TakuroFukamizu/cores3-ilda/firmware/README.md

# CoreS3ファームウェア

今後の実装先です。まだソースコードはありません。Arduino／ESP-IDF／PlatformIO等の採用は未決定です。

GPIO割当、DAC設定、起動時レーザーOFFの要件は [ハードウェアREADME](../hardware/rev-a/README.md) を参照してください。生成物とローカル設定はGitに含めません。
