TakuroFukamizu/cores3-ilda/releases/rev-a/2026-10-02/README.md

# Rev.A 初回設計スナップショット

2026-10-02に作成した設計に対する製造データ・プレビュー・検査記録です。2026-10-06にモノレポへ移管しました。実基板による検証完了を意味しません。

- `manufacturing/`：Gerber、PTH/NPTHドリル、ジョブ情報、ドリル図
- `verification/`：ERC、DRC、理想DC解析の記録
- `schematic_svg/`：回路図全ページ
- `assembly-top.svg`、`board-top.svg`、`board-top.png`：配置／基板プレビュー

編集用設計は `hardware/rev-a/kicad/`、部品表は `hardware/rev-a/` にあります。変更後の成果物でこの初回記録を上書きせず、新しい日付のフォルダへ保存してください。製造時は該当する設計コミットも固定してください。
