TakuroFukamizu/cores3-ilda/docs/README.md

# 共通ドキュメント

ハードウェアとソフトウェアをまたぐ通信仕様、校正方法、実機評価記録、設計判断をここで管理します。

Rev.Aの現行仕様は [hardware/rev-a/README.md](../hardware/rev-a/README.md)、初回の電気ルール検査結果は [releases/rev-a/2026-10-02/verification](../releases/rev-a/2026-10-02/verification) を参照してください。
