TakuroFukamizu/cores3-ilda/software/README.md

# PC側ソフトウェア

評価・データ変換・制御用のツールやアプリを今後配置します。現時点では未実装です。
