TakuroFukamizu/cores3-ilda/releases/rev-a/2026-10-02/board-top.png

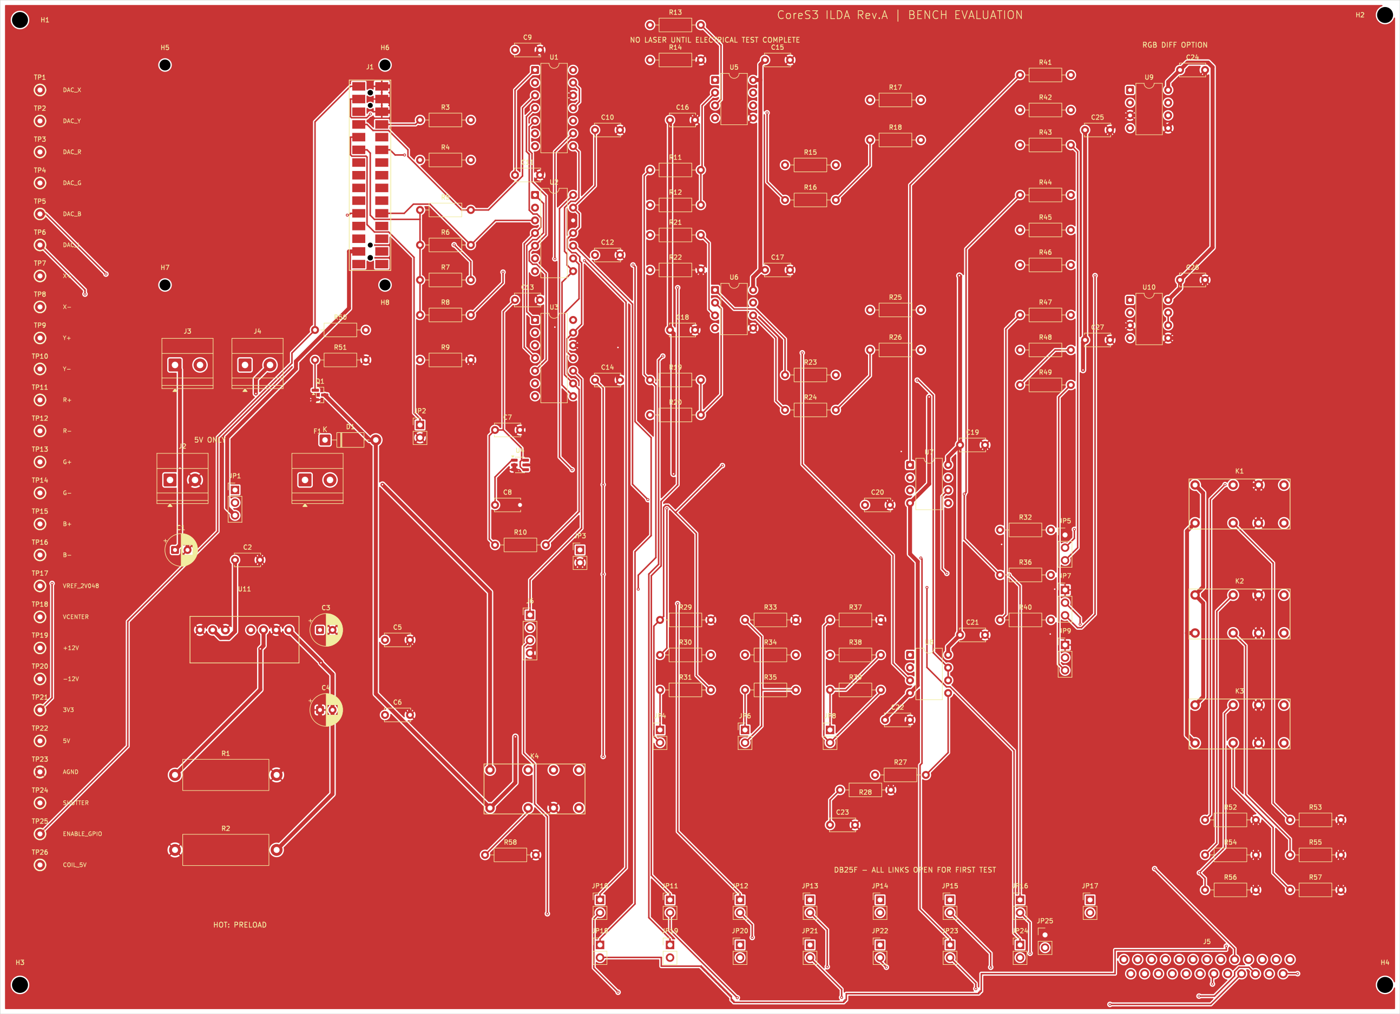
releases/rev-a/2026-10-02/board-top.png
