TakuroFukamizu/cores3-ilda/releases/rev-a/2026-10-02/verification/nominal_dc.csv

DAC_code | RGB_mode | Vcenter_V | Xplus_internal_V | Xminus_internal_V | XY_diff_V | RGBplus_internal_V | RGBminus_internal_V | RGB_diff_V
0 | SE | 1.024 | -4.8128 | 4.8128 | -9.6256 | 0.0 | 0 | 0.0
2048 | SE | 1.024 | 3.352467243869647e-16 | -3.3524672438696463e-16 | 6.704934487739293e-16 | 2.478080000000001 | 0 | 2.478080000000001
4095 | SE | 1.0240000000000002 | 4.810449999999999 | -4.810449999999999 | 9.620899999999997 | 4.954950000000002 | 0 | 4.954950000000002
0 | DIFF | 1.024 | -4.8128 | 4.8128 | -9.6256 | 0.0 | 0.0 | 0.0
2048 | DIFF | 1.024 | 3.352467243869647e-16 | -3.3524672438696463e-16 | 6.704934487739293e-16 | 1.249280018863645 | -1.2492800188636448 | 2.49856003772729
4095 | DIFF | 1.0240000000000002 | 4.810449999999999 | -4.810449999999999 | 9.620899999999997 | 2.4979500377180788 | -2.4979500377180788 | 4.9959000754361576
