TakuroFukamizu/cores3-ilda/hardware/rev-a/kicad/CoreS3_ILDA_RevA.kicad_pcb

## KiCad design hardware/rev-a/kicad/CoreS3_ILDA_RevA.kicad_pcb (2026-10-06)

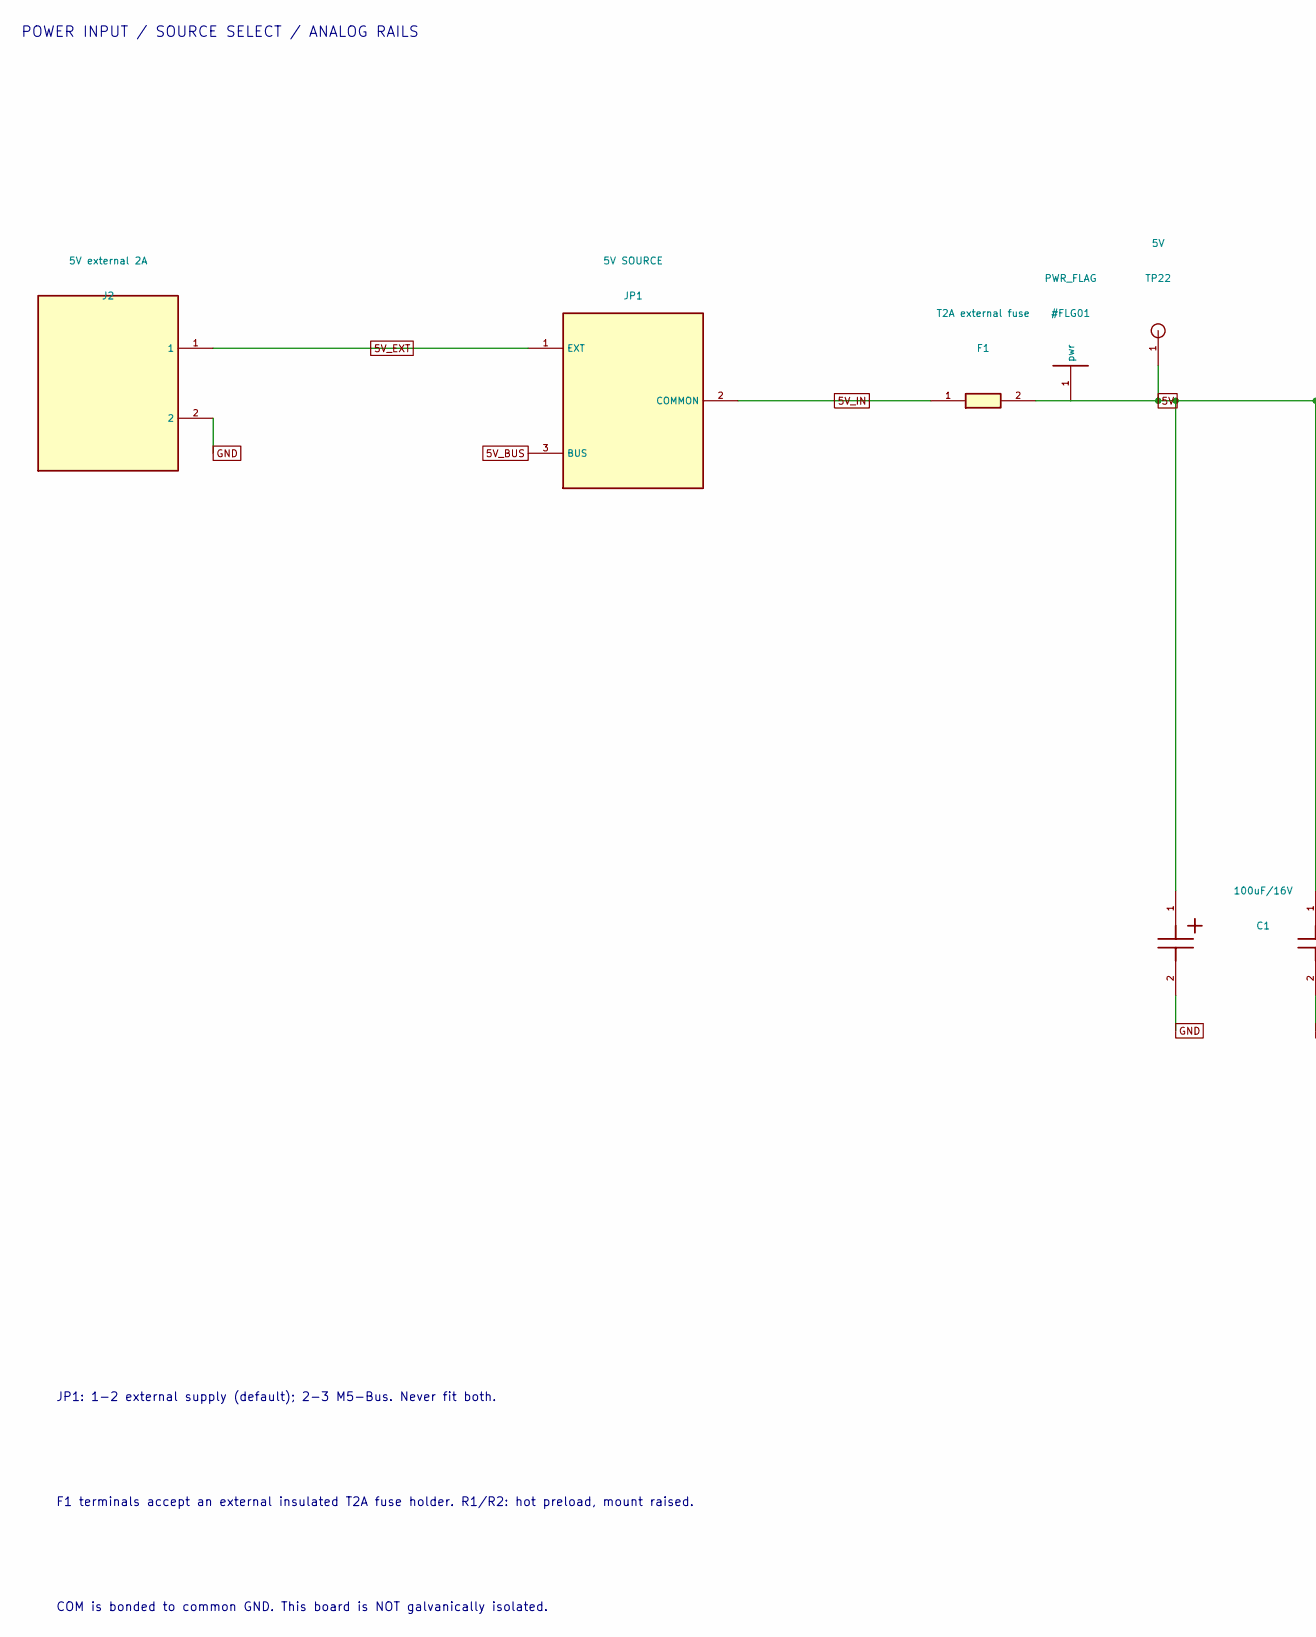
[picture p2: schematic 01_Host_and_power_1.kicad_sch, 01 / 5V input and +/-12V supply, part in row 1, column 1]

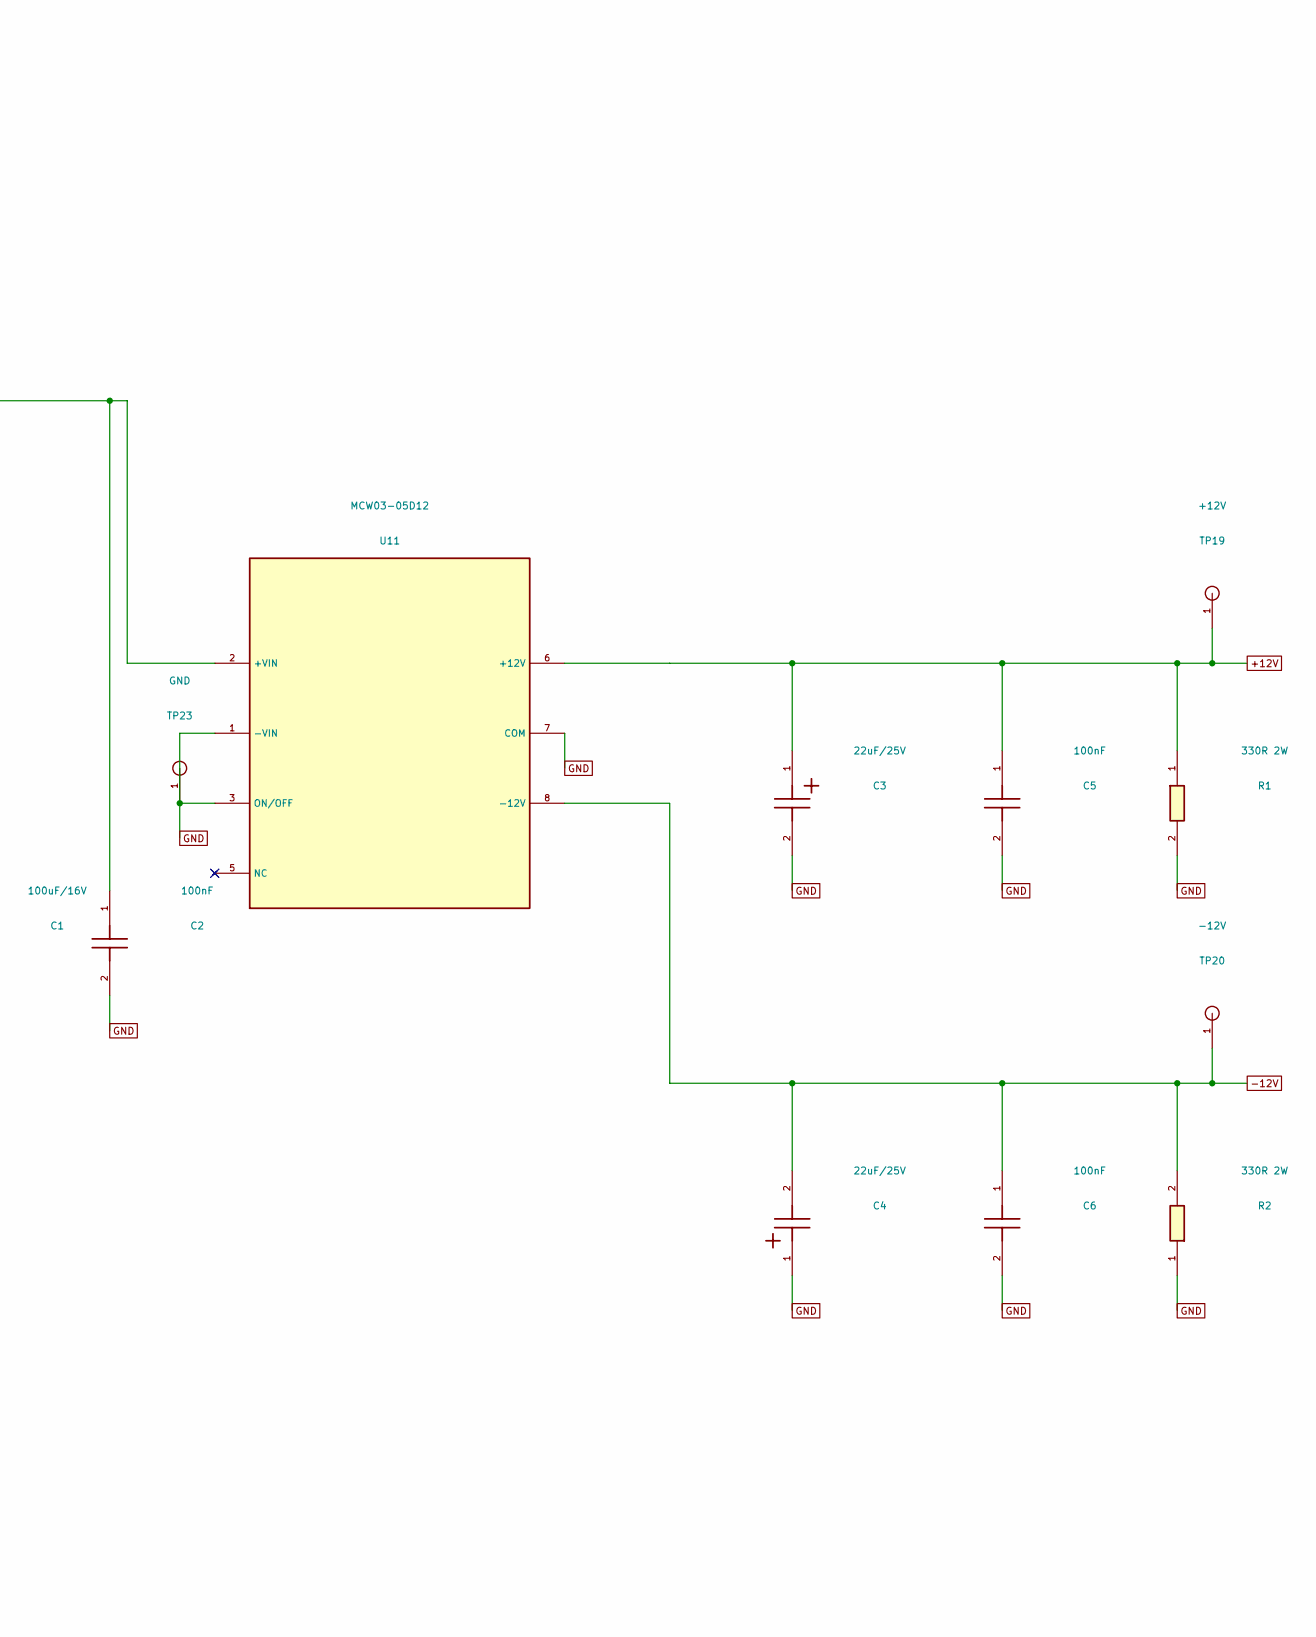
[picture p3: schematic 01_Host_and_power_1.kicad_sch, 01 / 5V input and +/-12V supply, part in row 1, column 2]

Parts:
C1: 100uF/16V; CP_Radial_D6.3mm_P2.50mm
C2, C5, C6: 100nF; C_Disc_D5.0mm_W2.5mm_P5.00mm
C3, C4: 22uF/25V; CP_Radial_D6.3mm_P2.50mm
F1: T2A external fuse; TerminalBlock_Phoenix_MKDS-1,5-2_1x02_P5.00mm_Horizontal
J2: 5V external 2A; TerminalBlock_Phoenix_MKDS-1,5-2_1x02_P5.00mm_Horizontal
JP1: 5V SOURCE; PinHeader_1x03_P2.54mm_Vertical
R1, R2: 330R 2W; R_Axial_DIN0617_L17.0mm_D6.0mm_P20.32mm_Horizontal
TP19: +12V; TestPoint_THTPad_D2.0mm_Drill1.0mm
TP20: -12V; TestPoint_THTPad_D2.0mm_Drill1.0mm
TP22: 5V; TestPoint_THTPad_D2.0mm_Drill1.0mm
TP23: GND; TestPoint_THTPad_D2.0mm_Drill1.0mm
U11: MCW03-05D12; MCW03_SIP8

Connections:
5V: C1.1, C2.1, F1.2, TP22.1, U11.2 (+VIN); also elsewhere on the board
5V_BUS: JP1.3 (BUS); also elsewhere on the board
5V_EXT: J2.1, JP1.1 (EXT)
5V_IN: F1.1, JP1.2 (COMMON)
+12V: C3.1, C5.1, R1.1, TP19.1, U11.6 (+12V); also elsewhere on the board
-12V: C4.2, C6.1, R2.2, TP20.1, U11.8 (-12V); also elsewhere on the board
GND: C1.2, C2.2, C3.2, C4.1, C5.2, C6.2, J2.2, R1.2, R2.1, TP23.1, U11.1 (-VIN), U11.3 (ON/OFF), U11.7 (COM); also elsewhere on the board

Notes on the sheet:
POWER INPUT / SOURCE SELECT / ANALOG RAILS
JP1: 1-2 external supply (default); 2-3 M5-Bus. Never fit both.
F1 terminals accept an external insulated T2A fuse holder. R1/R2: hot preload, mount raised.
COM is bonded to common GND. This board is NOT galvanically isolated.

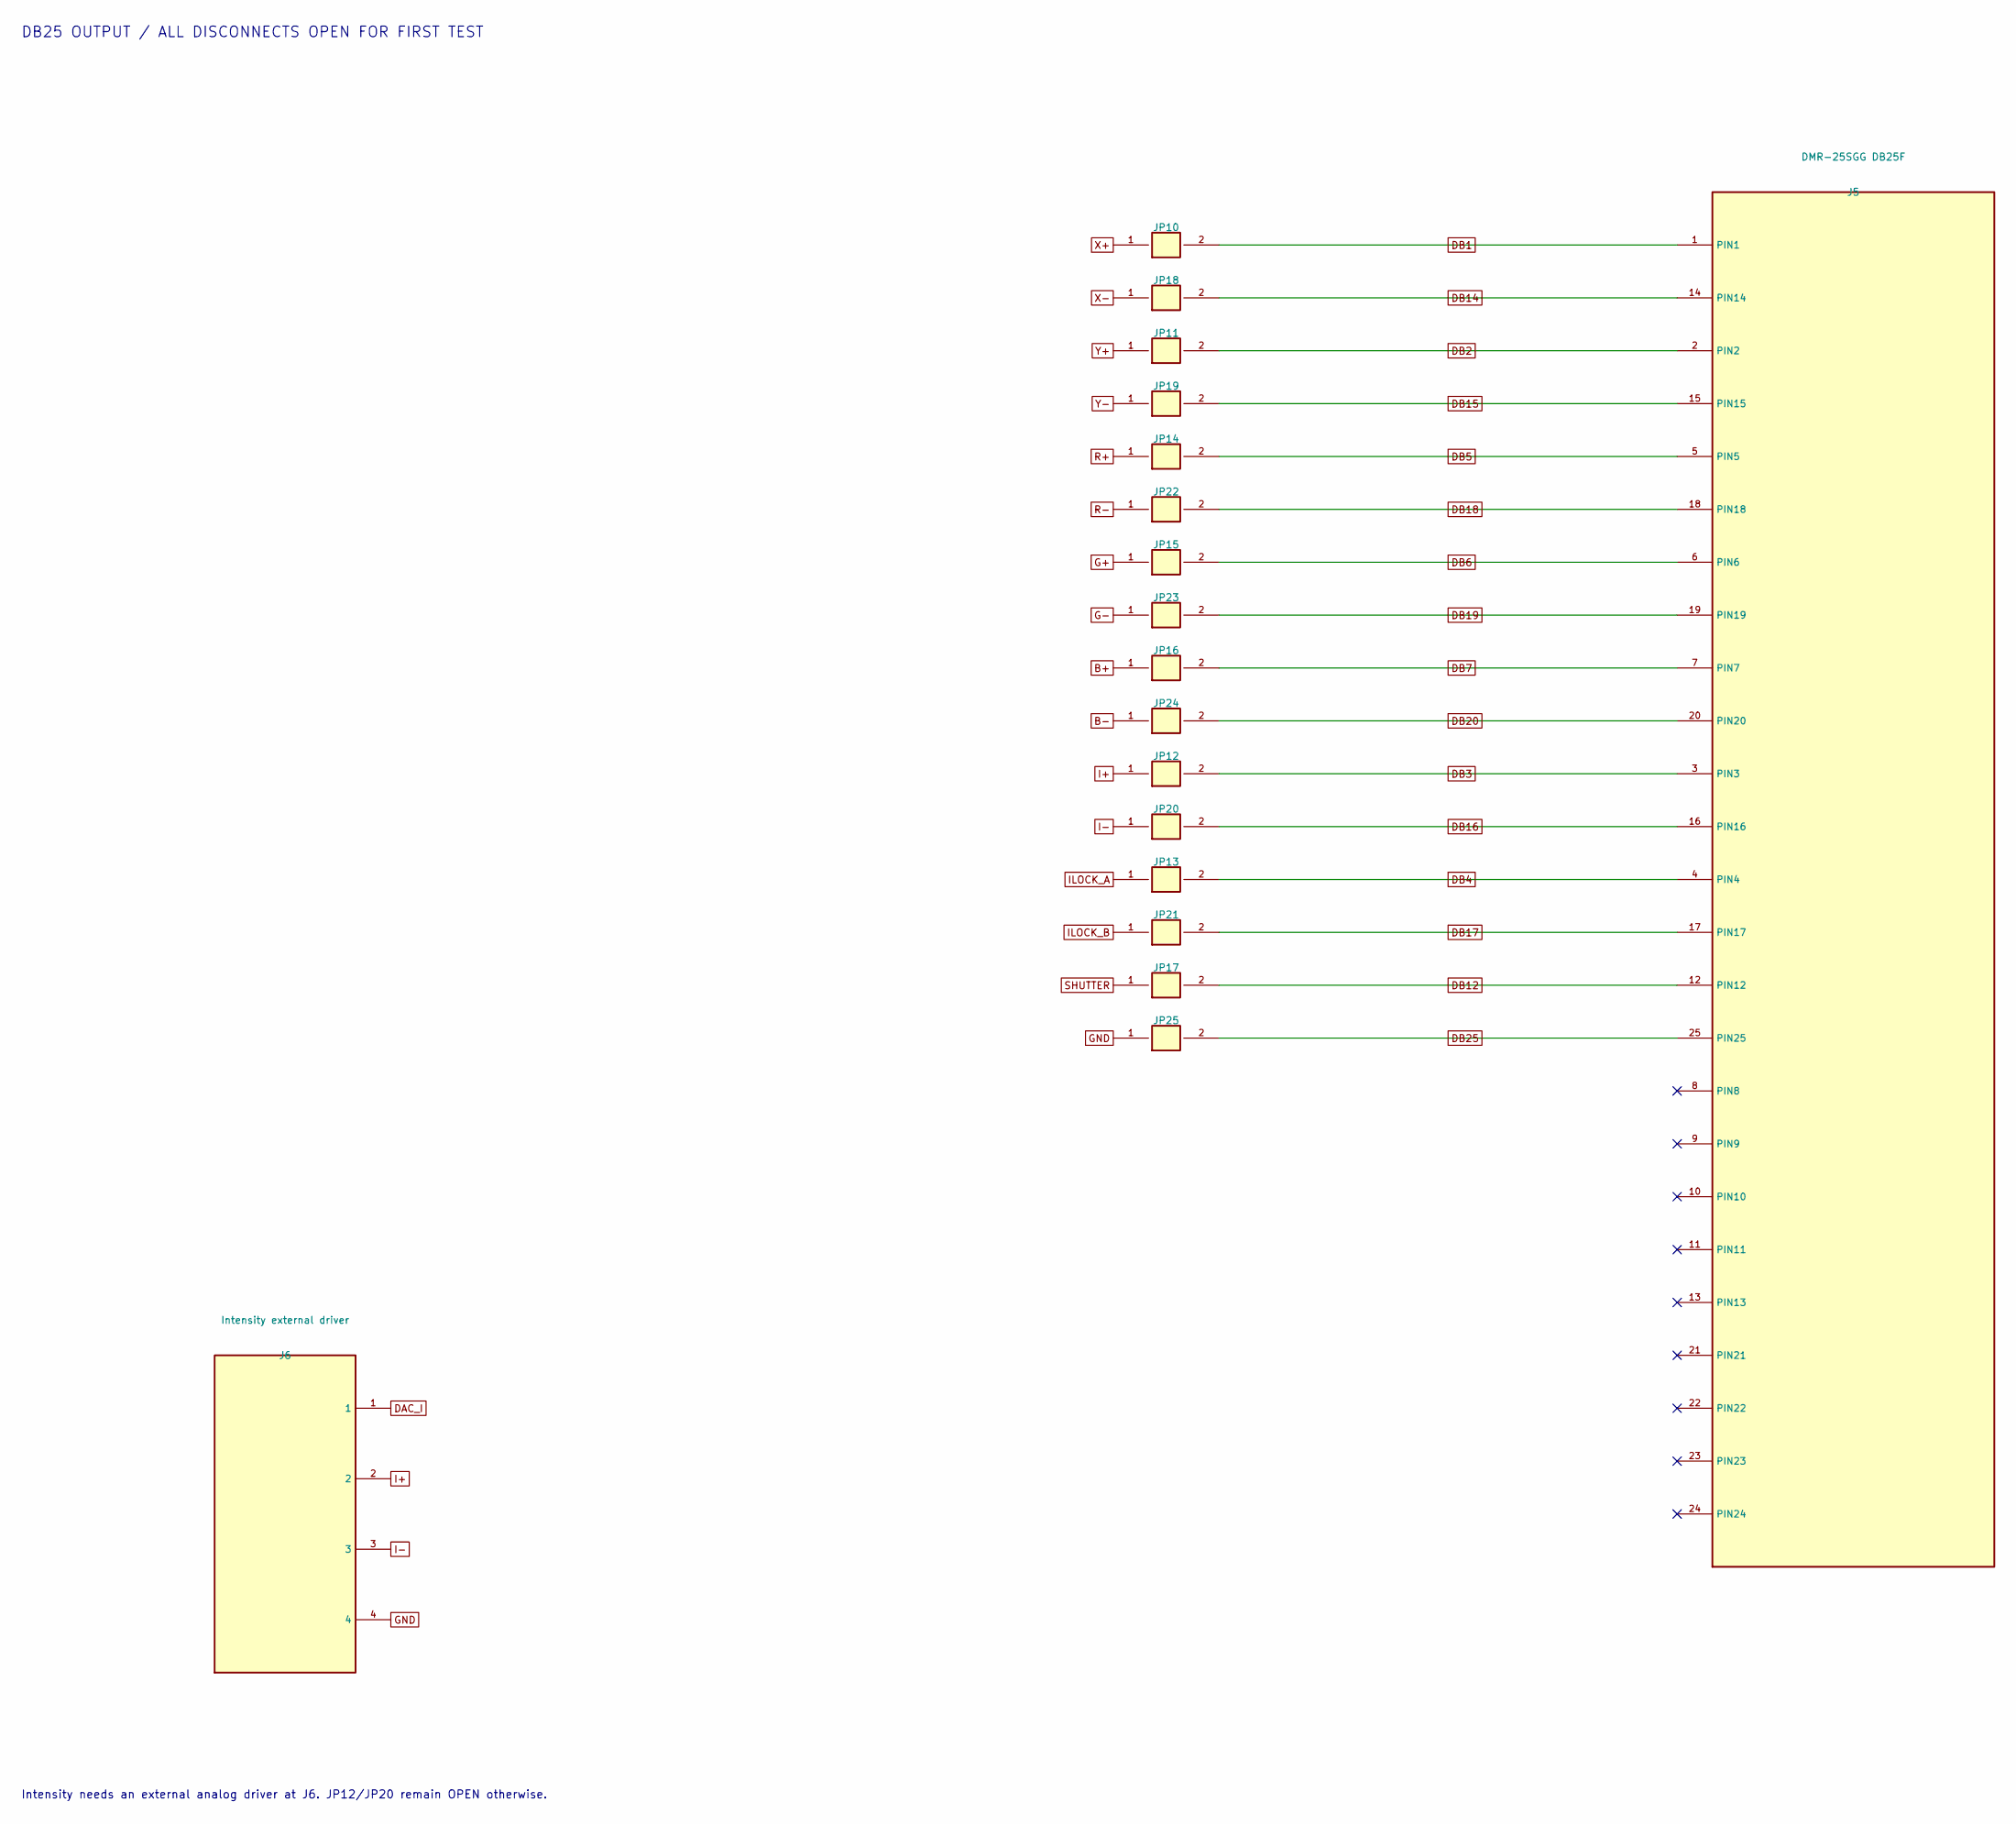
[picture p4: schematic 07_DB25_and_disconnects_1.kicad_sch, 12 / DB25 output and disconnect jumpers]

Parts:
J5: DMR-25SGG DB25F; DMR25SGG
J6: Intensity external driver; PinHeader_1x04_P2.54mm_Vertical
JP10: DB1 X+; PinHeader_1x02_P2.54mm_Vertical
JP11: DB2 Y+; PinHeader_1x02_P2.54mm_Vertical
JP12: DB3 I+; PinHeader_1x02_P2.54mm_Vertical
JP13: DB4 ILOCK_A; PinHeader_1x02_P2.54mm_Vertical
JP14: DB5 R+; PinHeader_1x02_P2.54mm_Vertical
JP15: DB6 G+; PinHeader_1x02_P2.54mm_Vertical
JP16: DB7 B+; PinHeader_1x02_P2.54mm_Vertical
JP17: DB12 SHUTTER; PinHeader_1x02_P2.54mm_Vertical
JP18: DB14 X-; PinHeader_1x02_P2.54mm_Vertical
JP19: DB15 Y-; PinHeader_1x02_P2.54mm_Vertical
JP20: DB16 I-; PinHeader_1x02_P2.54mm_Vertical
JP21: DB17 ILOCK_B; PinHeader_1x02_P2.54mm_Vertical
JP22: DB18 R-; PinHeader_1x02_P2.54mm_Vertical
JP23: DB19 G-; PinHeader_1x02_P2.54mm_Vertical
JP24: DB20 B-; PinHeader_1x02_P2.54mm_Vertical
JP25: DB25 GND; PinHeader_1x02_P2.54mm_Vertical

Connections:
B+: JP16.1; also elsewhere on the board
B-: JP24.1; also elsewhere on the board
DAC_I: J6.1; also elsewhere on the board
DB1: J5.1 (PIN1), JP10.2
DB2: J5.2 (PIN2), JP11.2
DB3: J5.3 (PIN3), JP12.2
DB4: J5.4 (PIN4), JP13.2
DB5: J5.5 (PIN5), JP14.2
DB6: J5.6 (PIN6), JP15.2
DB7: J5.7 (PIN7), JP16.2
DB12: J5.12 (PIN12), JP17.2
DB14: J5.14 (PIN14), JP18.2
DB15: J5.15 (PIN15), JP19.2
DB16: J5.16 (PIN16), JP20.2
DB17: J5.17 (PIN17), JP21.2
DB18: J5.18 (PIN18), JP22.2
DB19: J5.19 (PIN19), JP23.2
DB20: J5.20 (PIN20), JP24.2
DB25: J5.25 (PIN25), JP25.2
G+: JP15.1; also elsewhere on the board
G-: JP23.1; also elsewhere on the board
GND: J6.4, JP25.1; also elsewhere on the board
I+: J6.2, JP12.1
I-: J6.3, JP20.1
ILOCK_A: JP13.1; also elsewhere on the board
ILOCK_B: JP21.1; also elsewhere on the board
R+: JP14.1; also elsewhere on the board
R-: JP22.1; also elsewhere on the board
SHUTTER: JP17.1; also elsewhere on the board
X+: JP10.1; also elsewhere on the board
X-: JP18.1; also elsewhere on the board
Y+: JP11.1; also elsewhere on the board
Y-: JP19.1; also elsewhere on the board

Notes on the sheet:
DB25 OUTPUT / ALL DISCONNECTS OPEN FOR FIRST TEST
Intensity needs an external analog driver at J6. JP12/JP20 remain OPEN otherwise.

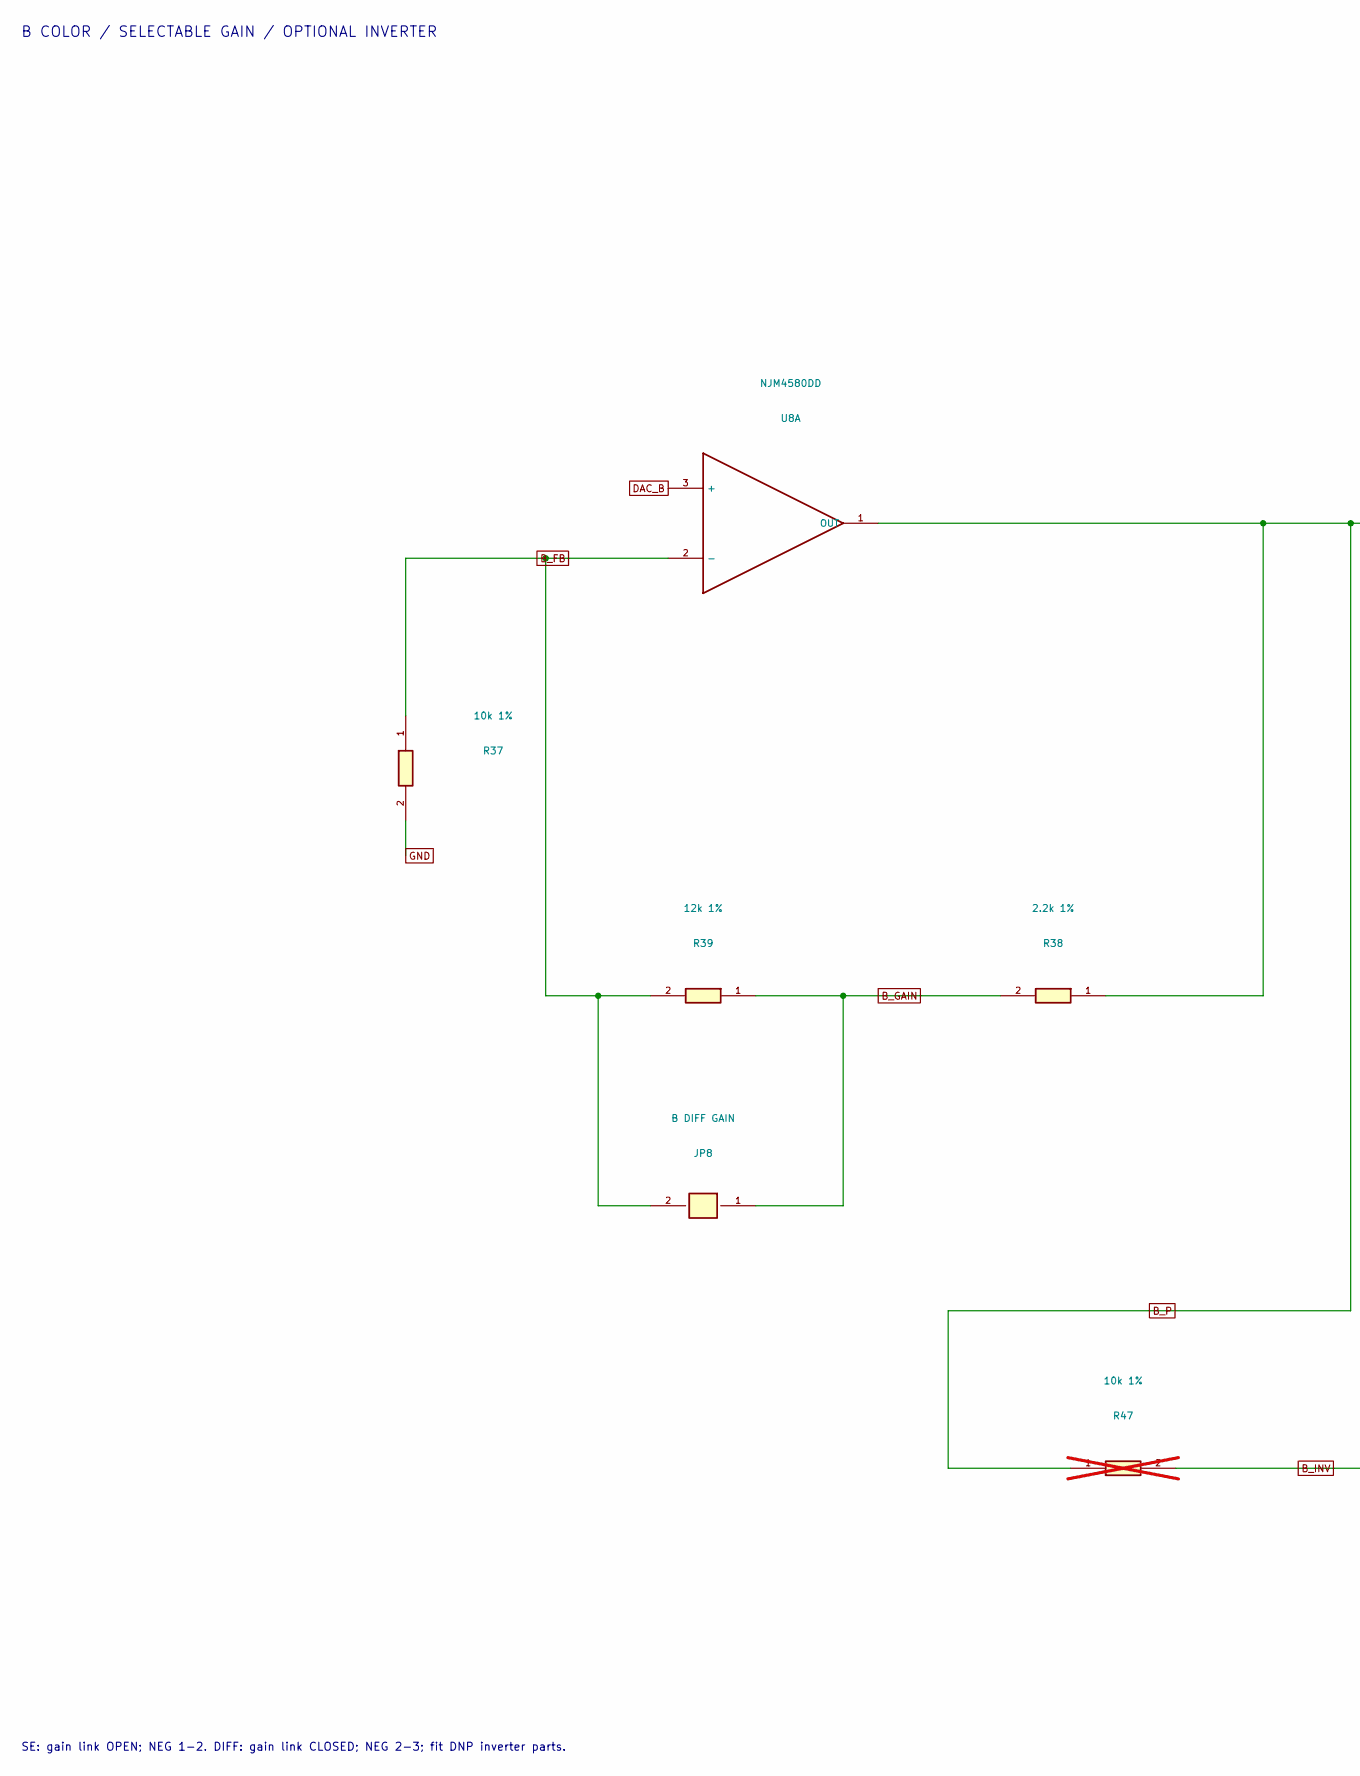
[picture p5: schematic 05_RGB_optional_inverters.kicad_sch, B / Color driver and optional differential stage, part in row 1, column 1]

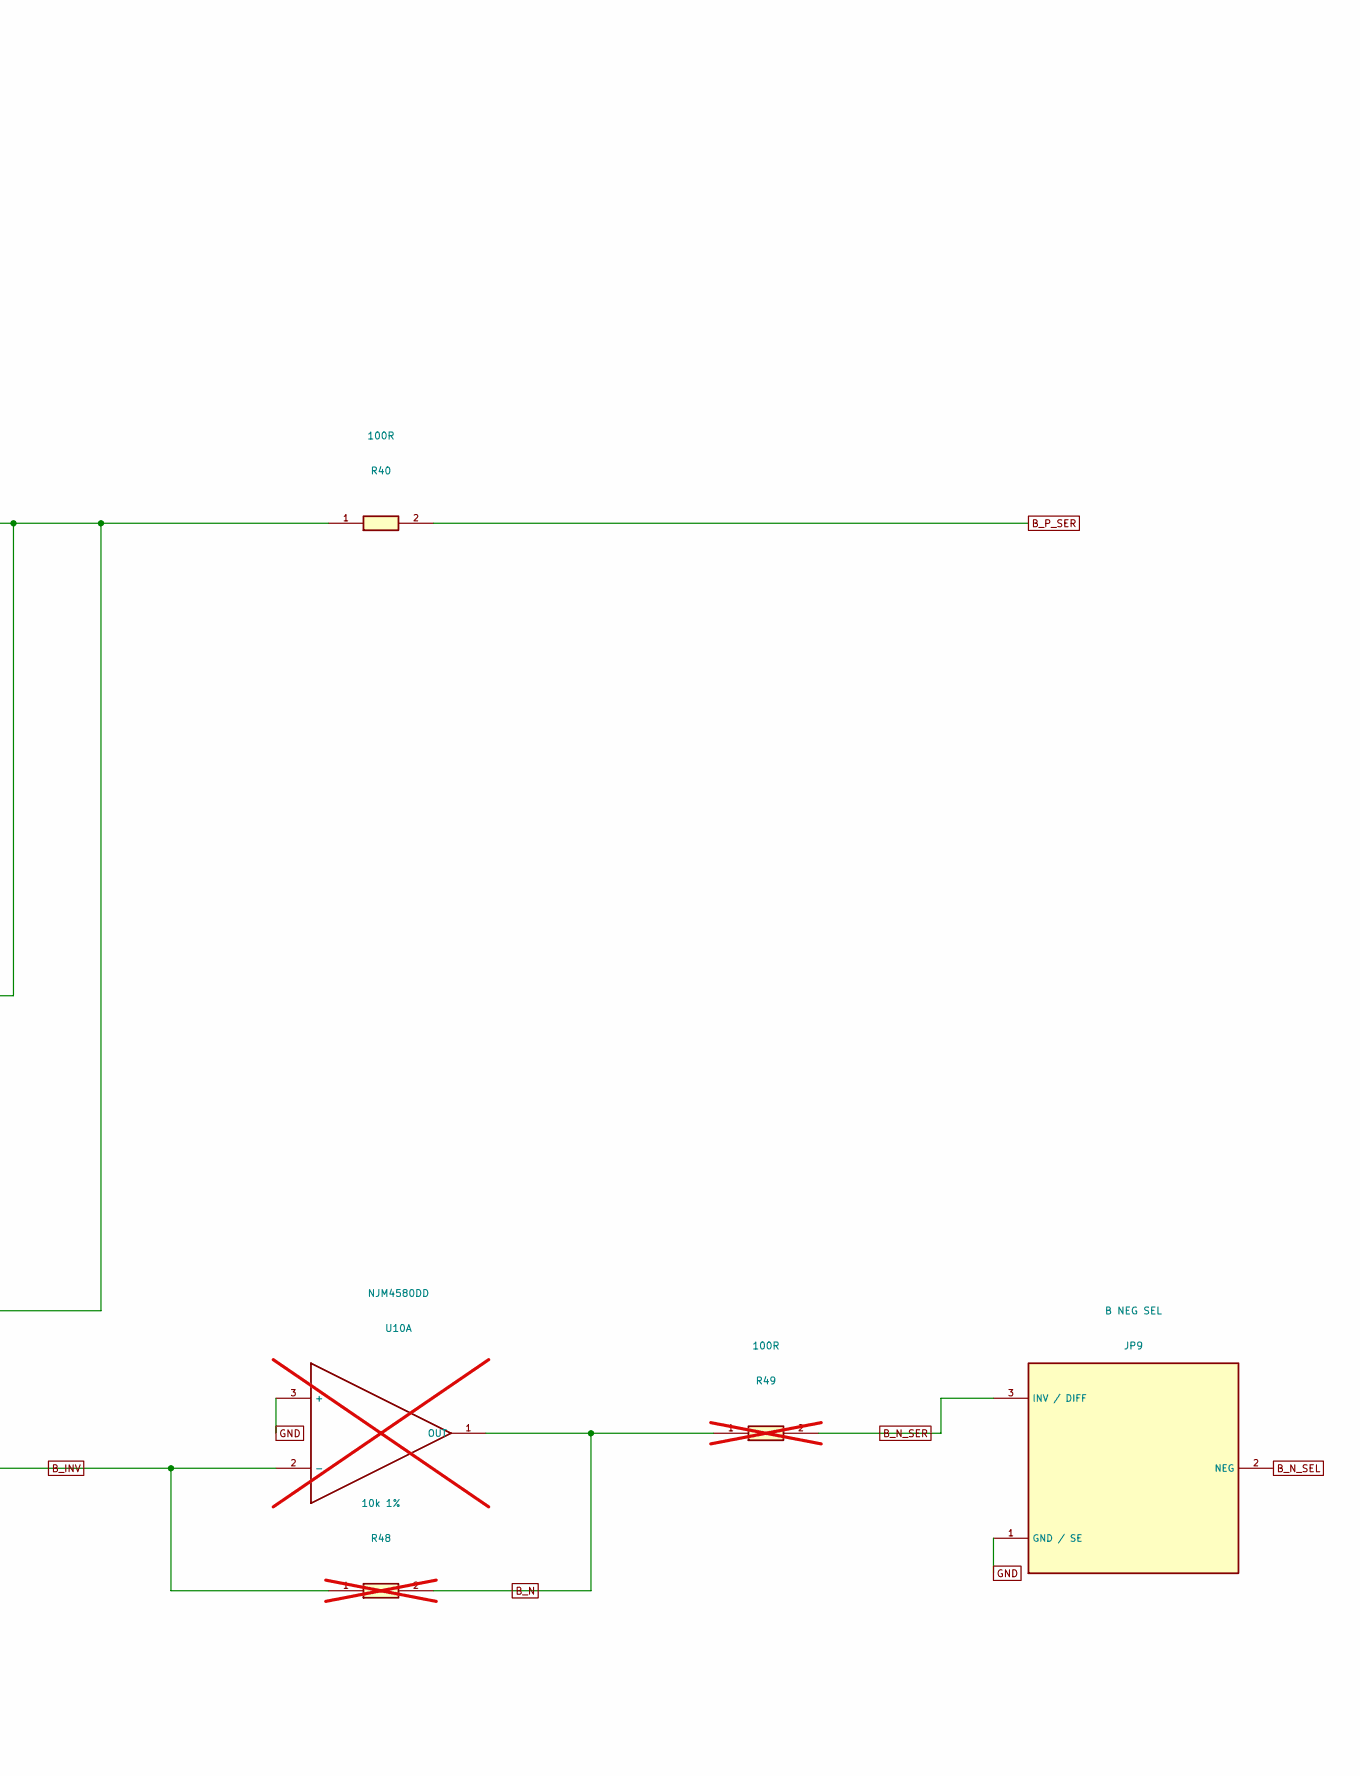
[picture p6: schematic 05_RGB_optional_inverters.kicad_sch, B / Color driver and optional differential stage, part in row 1, column 2]

Parts:
JP8: B DIFF GAIN; PinHeader_1x02_P2.54mm_Vertical
JP9: B NEG SEL; PinHeader_1x03_P2.54mm_Vertical
R37: 10k 1%; R_Axial_DIN0207_L6.3mm_D2.5mm_P10.16mm_Horizontal
R38: 2.2k 1%; R_Axial_DIN0207_L6.3mm_D2.5mm_P10.16mm_Horizontal
R39: 12k 1%; R_Axial_DIN0207_L6.3mm_D2.5mm_P10.16mm_Horizontal
R40: 100R; R_Axial_DIN0207_L6.3mm_D2.5mm_P10.16mm_Horizontal
R47, R48: 10k 1%; R_Axial_DIN0207_L6.3mm_D2.5mm_P10.16mm_Horizontal; not fitted
R49: 100R; R_Axial_DIN0207_L6.3mm_D2.5mm_P10.16mm_Horizontal; not fitted
U8: NJM4580DD; DIP-8_W7.62mm
U10: NJM4580DD; DIP-8_W7.62mm; not fitted

Connections:
B_FB: JP8.2, R37.1, R39.2, U8.2 (-)
B_GAIN: JP8.1, R38.2, R39.1
B_INV: R47.2, R48.1, U10.2 (-)
B_N: R48.2, R49.1, U10.1 (OUT)
B_N_SEL: JP9.2 (NEG); also elsewhere on the board
B_N_SER: JP9.3 (INV / DIFF), R49.2
B_P: R38.1, R40.1, R47.1, U8.1 (OUT)
B_P_SER: R40.2; also elsewhere on the board
DAC_B: U8.3 (+); also elsewhere on the board
GND: JP9.1 (GND / SE), R37.2, U10.3 (+); also elsewhere on the board

Notes on the sheet:
B COLOR / SELECTABLE GAIN / OPTIONAL INVERTER
SE: gain link OPEN; NEG 1-2. DIFF: gain link CLOSED; NEG 2-3; fit DNP inverter parts.

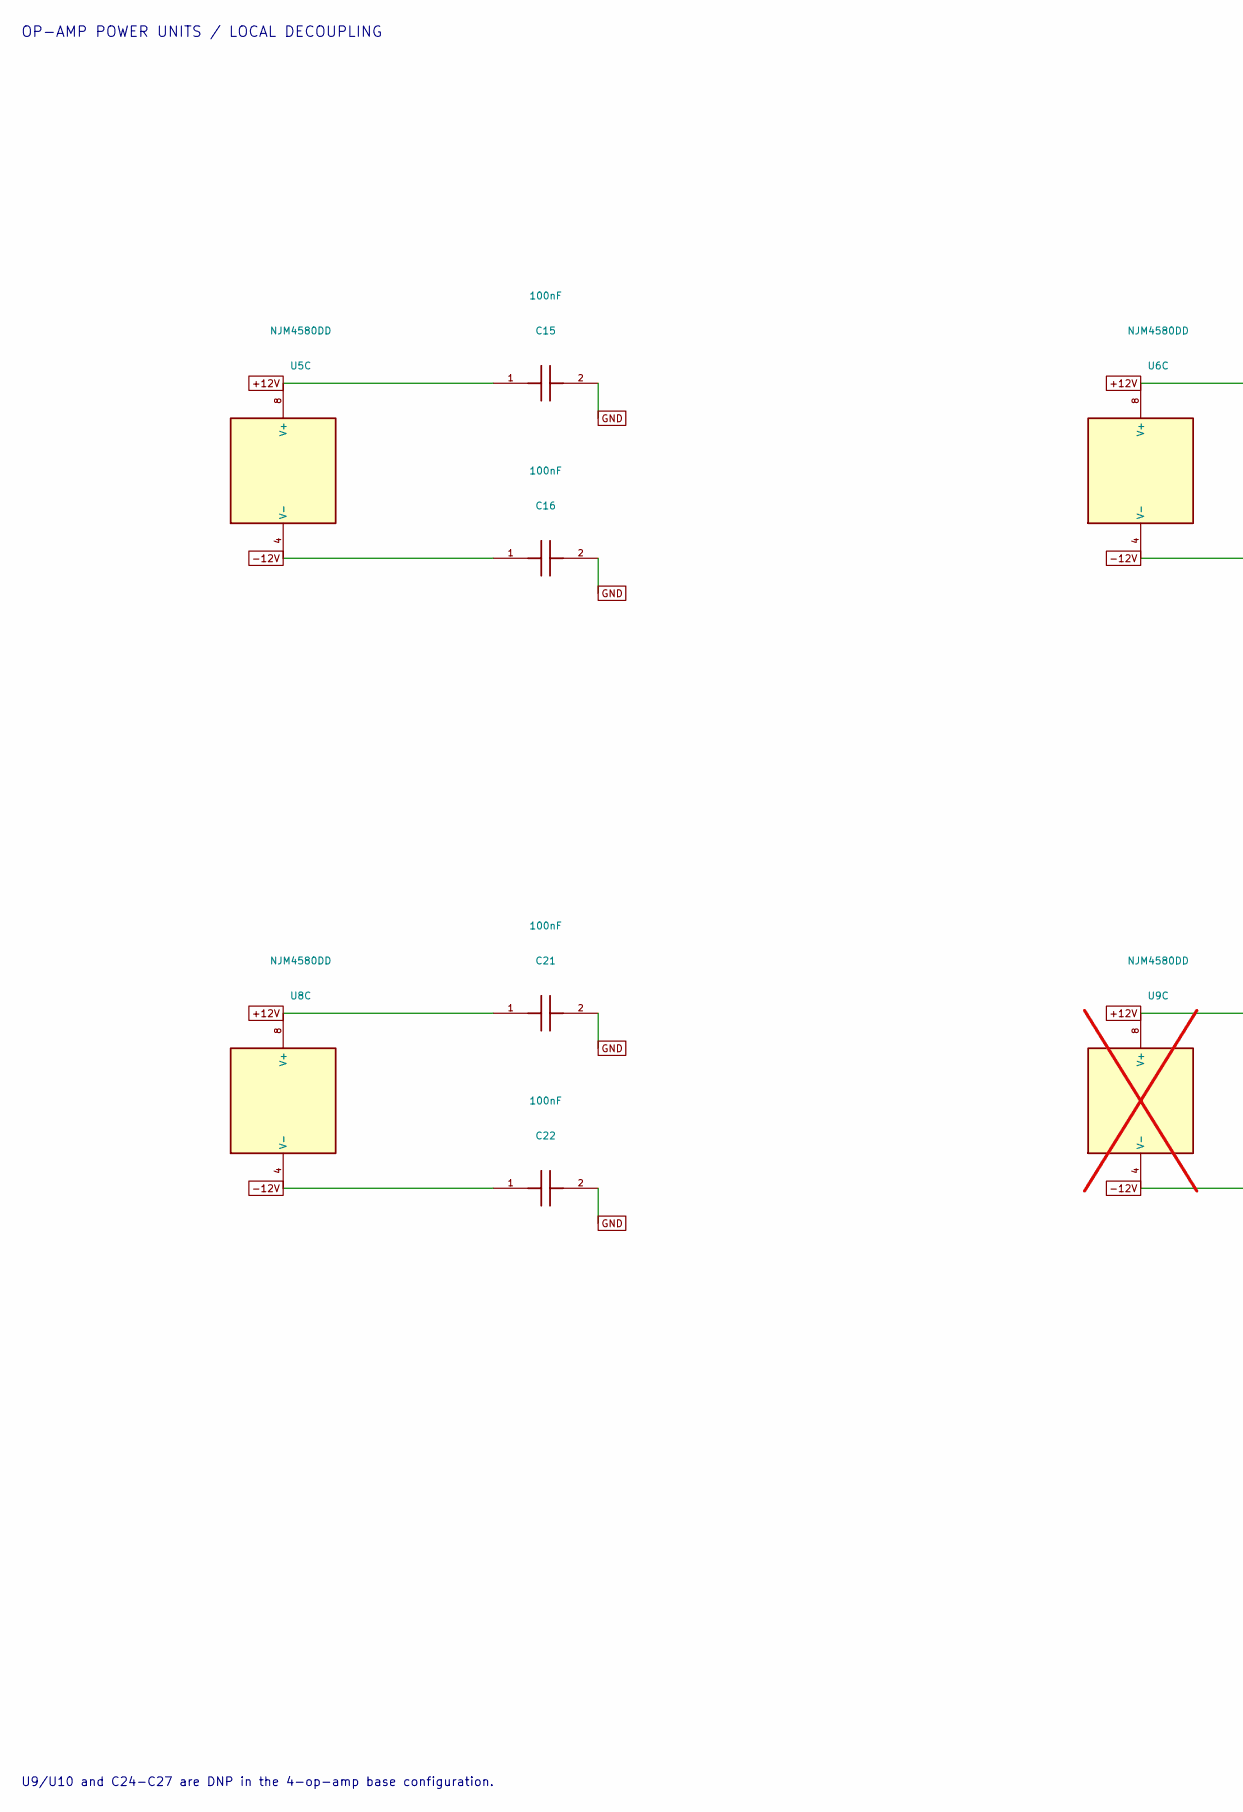
[picture p7: schematic 07_DB25_and_disconnects_2.kicad_sch, 13 / Op-amp power and unused section, part in row 1, column 1]

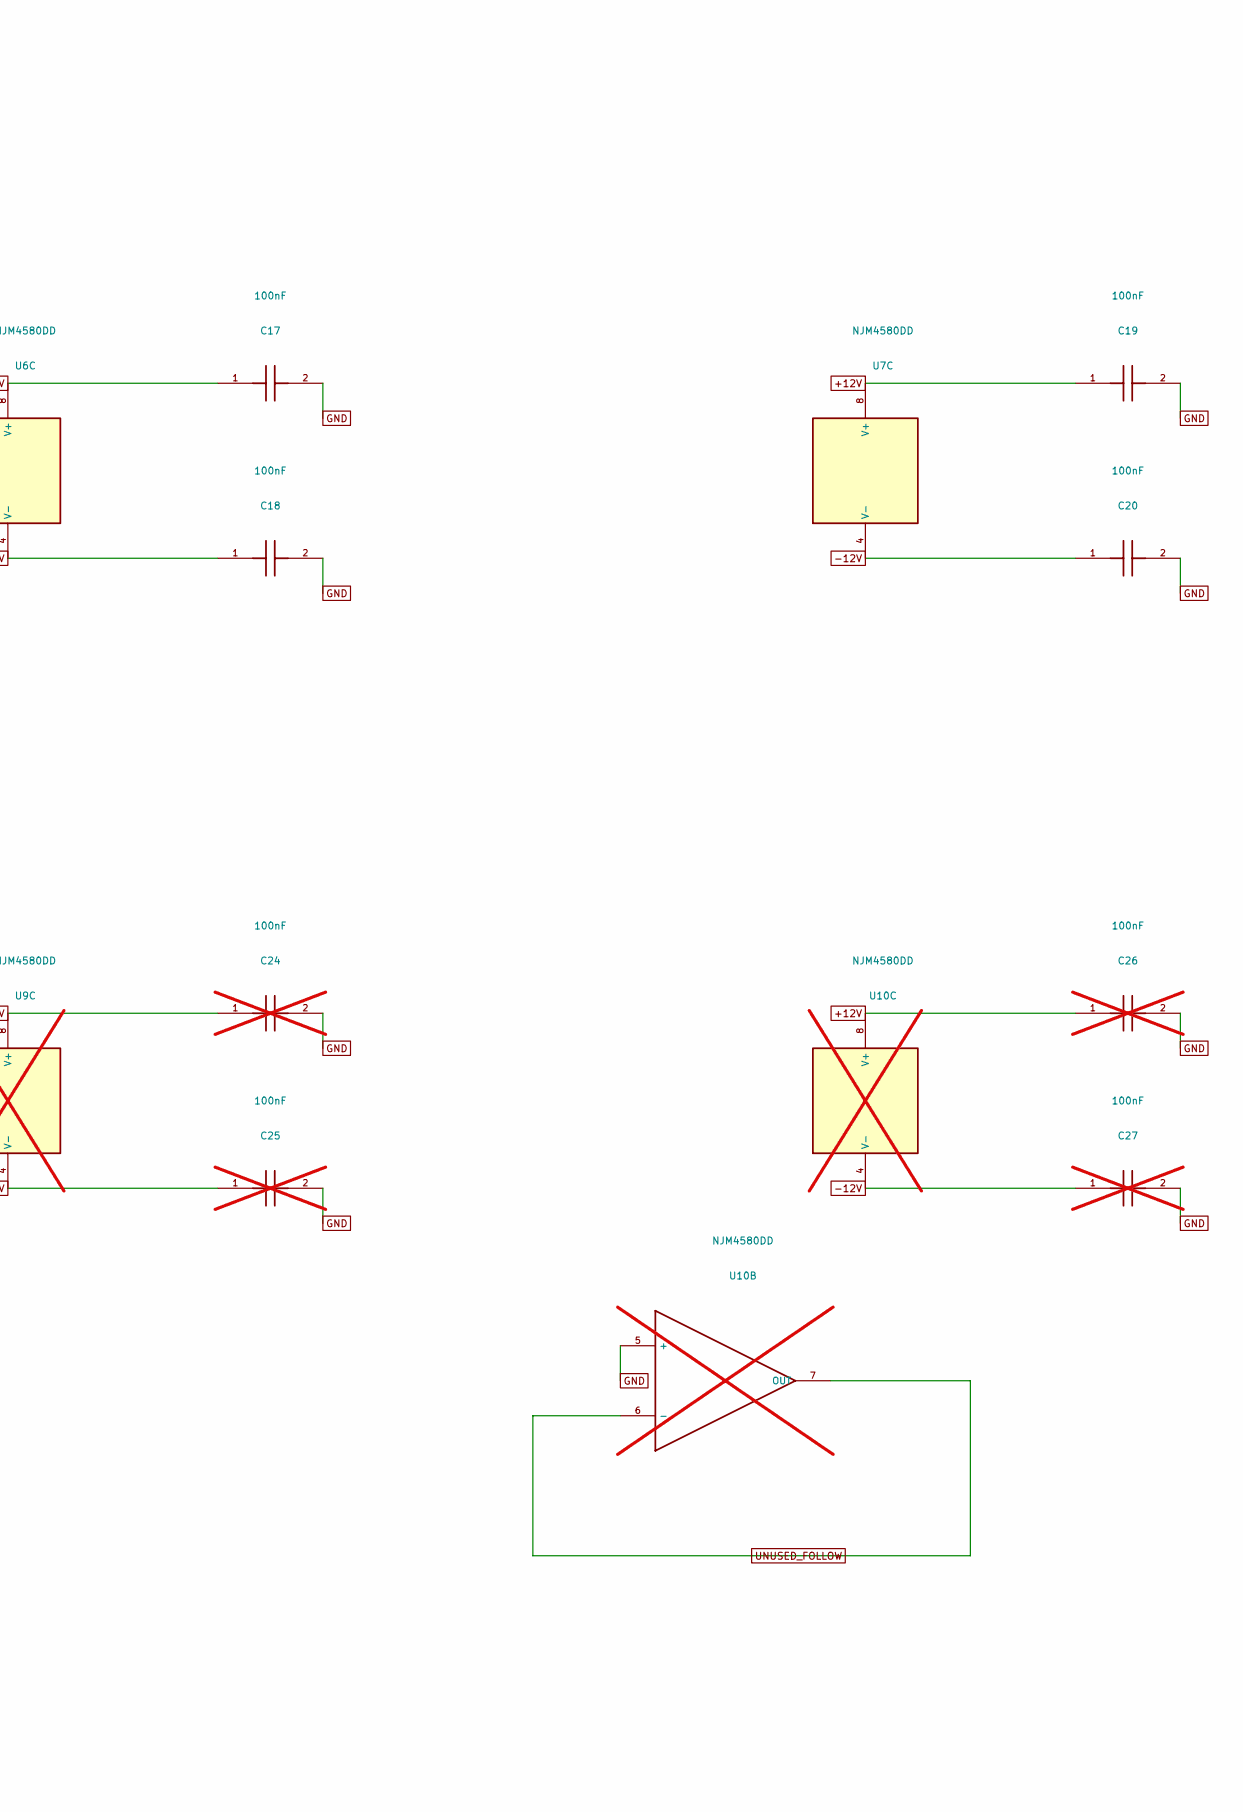
[picture p8: schematic 07_DB25_and_disconnects_2.kicad_sch, 13 / Op-amp power and unused section, part in row 1, column 2]

Parts:
C15, C16, C17, C18, C19, C20, C21, C22: 100nF; C_Disc_D5.0mm_W2.5mm_P5.00mm
C24, C25, C26, C27: 100nF; C_Disc_D5.0mm_W2.5mm_P5.00mm; not fitted
U5, U6, U7, U8: NJM4580DD; DIP-8_W7.62mm
U9, U10: NJM4580DD; DIP-8_W7.62mm; not fitted

Connections:
+12V: C15.1, C17.1, C19.1, C21.1, C24.1, C26.1, U5.8 (V+), U6.8 (V+), U7.8 (V+), U8.8 (V+), U9.8 (V+), U10.8 (V+); also elsewhere on the board
-12V: C16.1, C18.1, C20.1, C22.1, C25.1, C27.1, U5.4 (V-), U6.4 (V-), U7.4 (V-), U8.4 (V-), U9.4 (V-), U10.4 (V-); also elsewhere on the board
GND: C15.2, C16.2, C17.2, C18.2, C19.2, C20.2, C21.2, C22.2, C24.2, C25.2, C26.2, C27.2, U10.5 (+); also elsewhere on the board
UNUSED_FOLLOW: U10.6 (-), U10.7 (OUT)

Notes on the sheet:
OP-AMP POWER UNITS / LOCAL DECOUPLING
U9/U10 and C24-C27 are DNP in the 4-op-amp base configuration.
