TakuroFukamizu/cores3-ilda/hardware/rev-a/kicad/CoreS3_ILDA_RevA.kicad_pcb

## KiCad design hardware/rev-a/kicad/CoreS3_ILDA_RevA.kicad_pcb (continued)

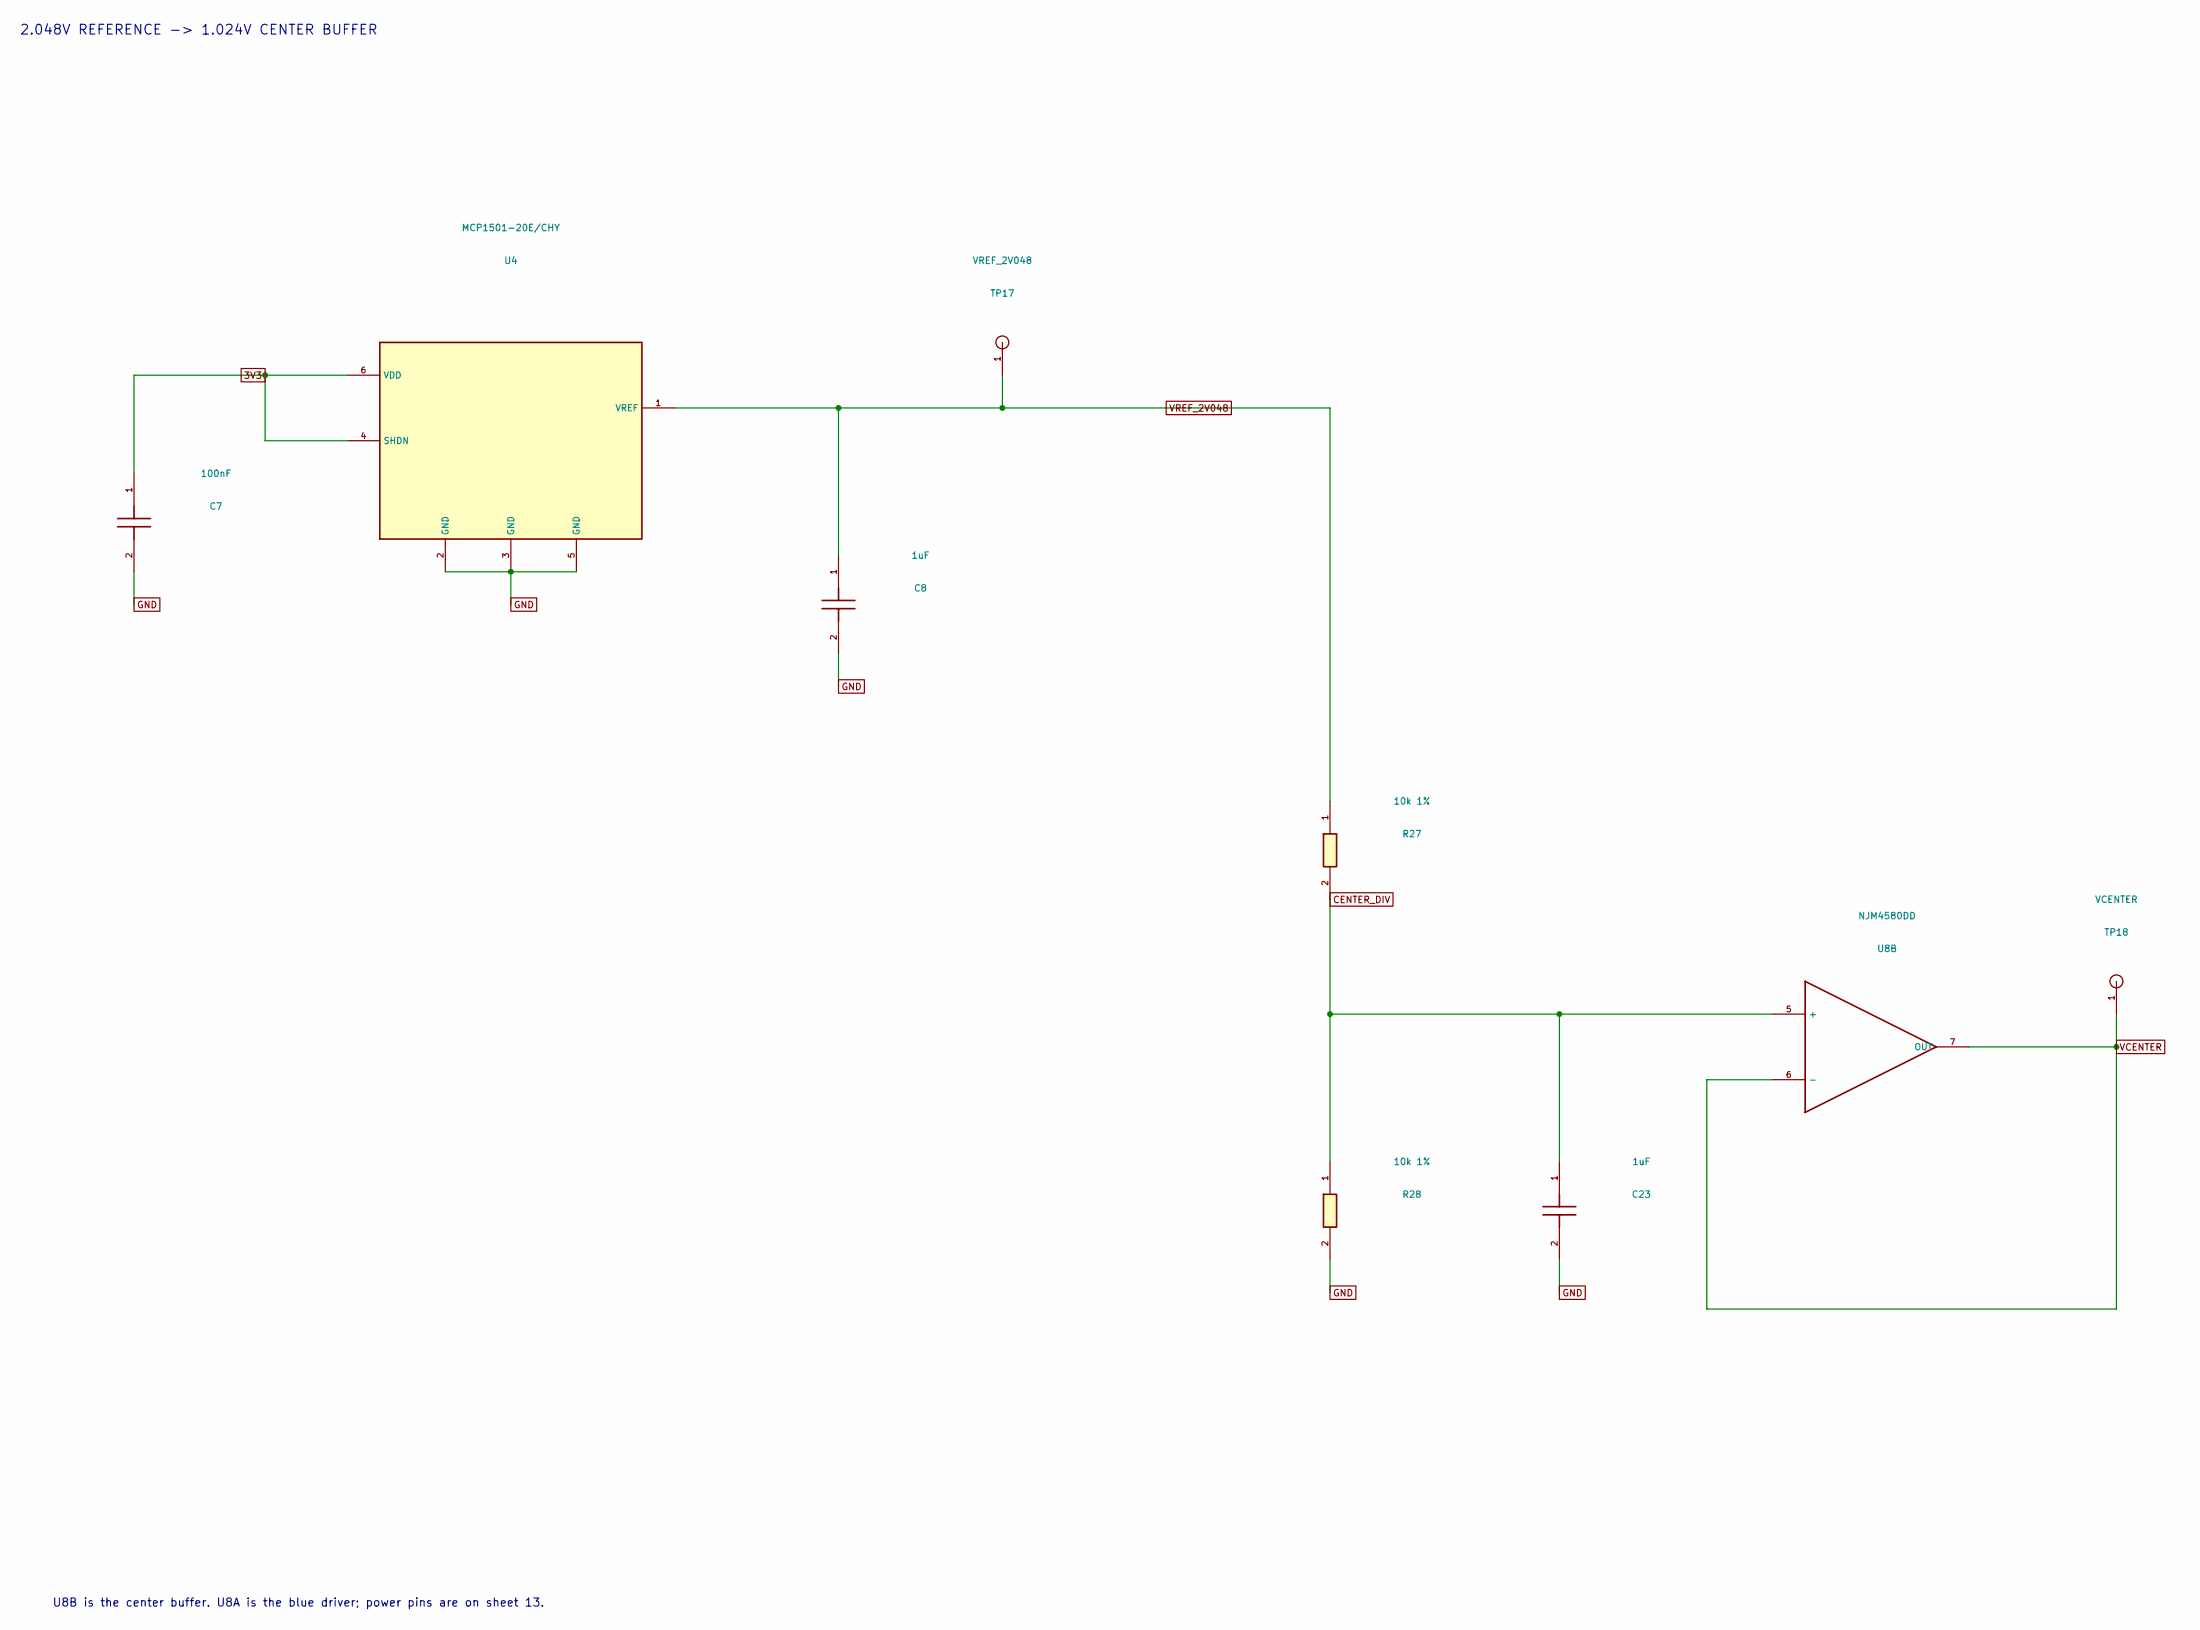
[picture p9: schematic 02_DAC_and_reference_1.kicad_sch, 03 / Precision reference and XY center]

Parts:
C7: 100nF; C_Disc_D5.0mm_W2.5mm_P5.00mm
C8, C23: 1uF; C_Disc_D5.0mm_W2.5mm_P5.00mm
R27, R28: 10k 1%; R_Axial_DIN0207_L6.3mm_D2.5mm_P10.16mm_Horizontal
TP17: VREF_2V048; TestPoint_THTPad_D2.0mm_Drill1.0mm
TP18: VCENTER; TestPoint_THTPad_D2.0mm_Drill1.0mm
U4: MCP1501-20E/CHY; SOT-23-6
U8: NJM4580DD; DIP-8_W7.62mm

Connections:
3V3: C7.1, U4.4 (SHDN), U4.6 (VDD); also elsewhere on the board
CENTER_DIV: C23.1, R27.2, R28.1, U8.5 (+)
GND: C7.2, C8.2, C23.2, R28.2, U4.2 (GND), U4.3 (GND), U4.5 (GND); also elsewhere on the board
VCENTER: TP18.1, U8.6 (-), U8.7 (OUT); also elsewhere on the board
VREF_2V048: C8.1, R27.1, TP17.1, U4.1 (VREF); also elsewhere on the board

Notes on the sheet:
2.048V REFERENCE -> 1.024V CENTER BUFFER
U8B is the center buffer. U8A is the blue driver; power pins are on sheet 13.

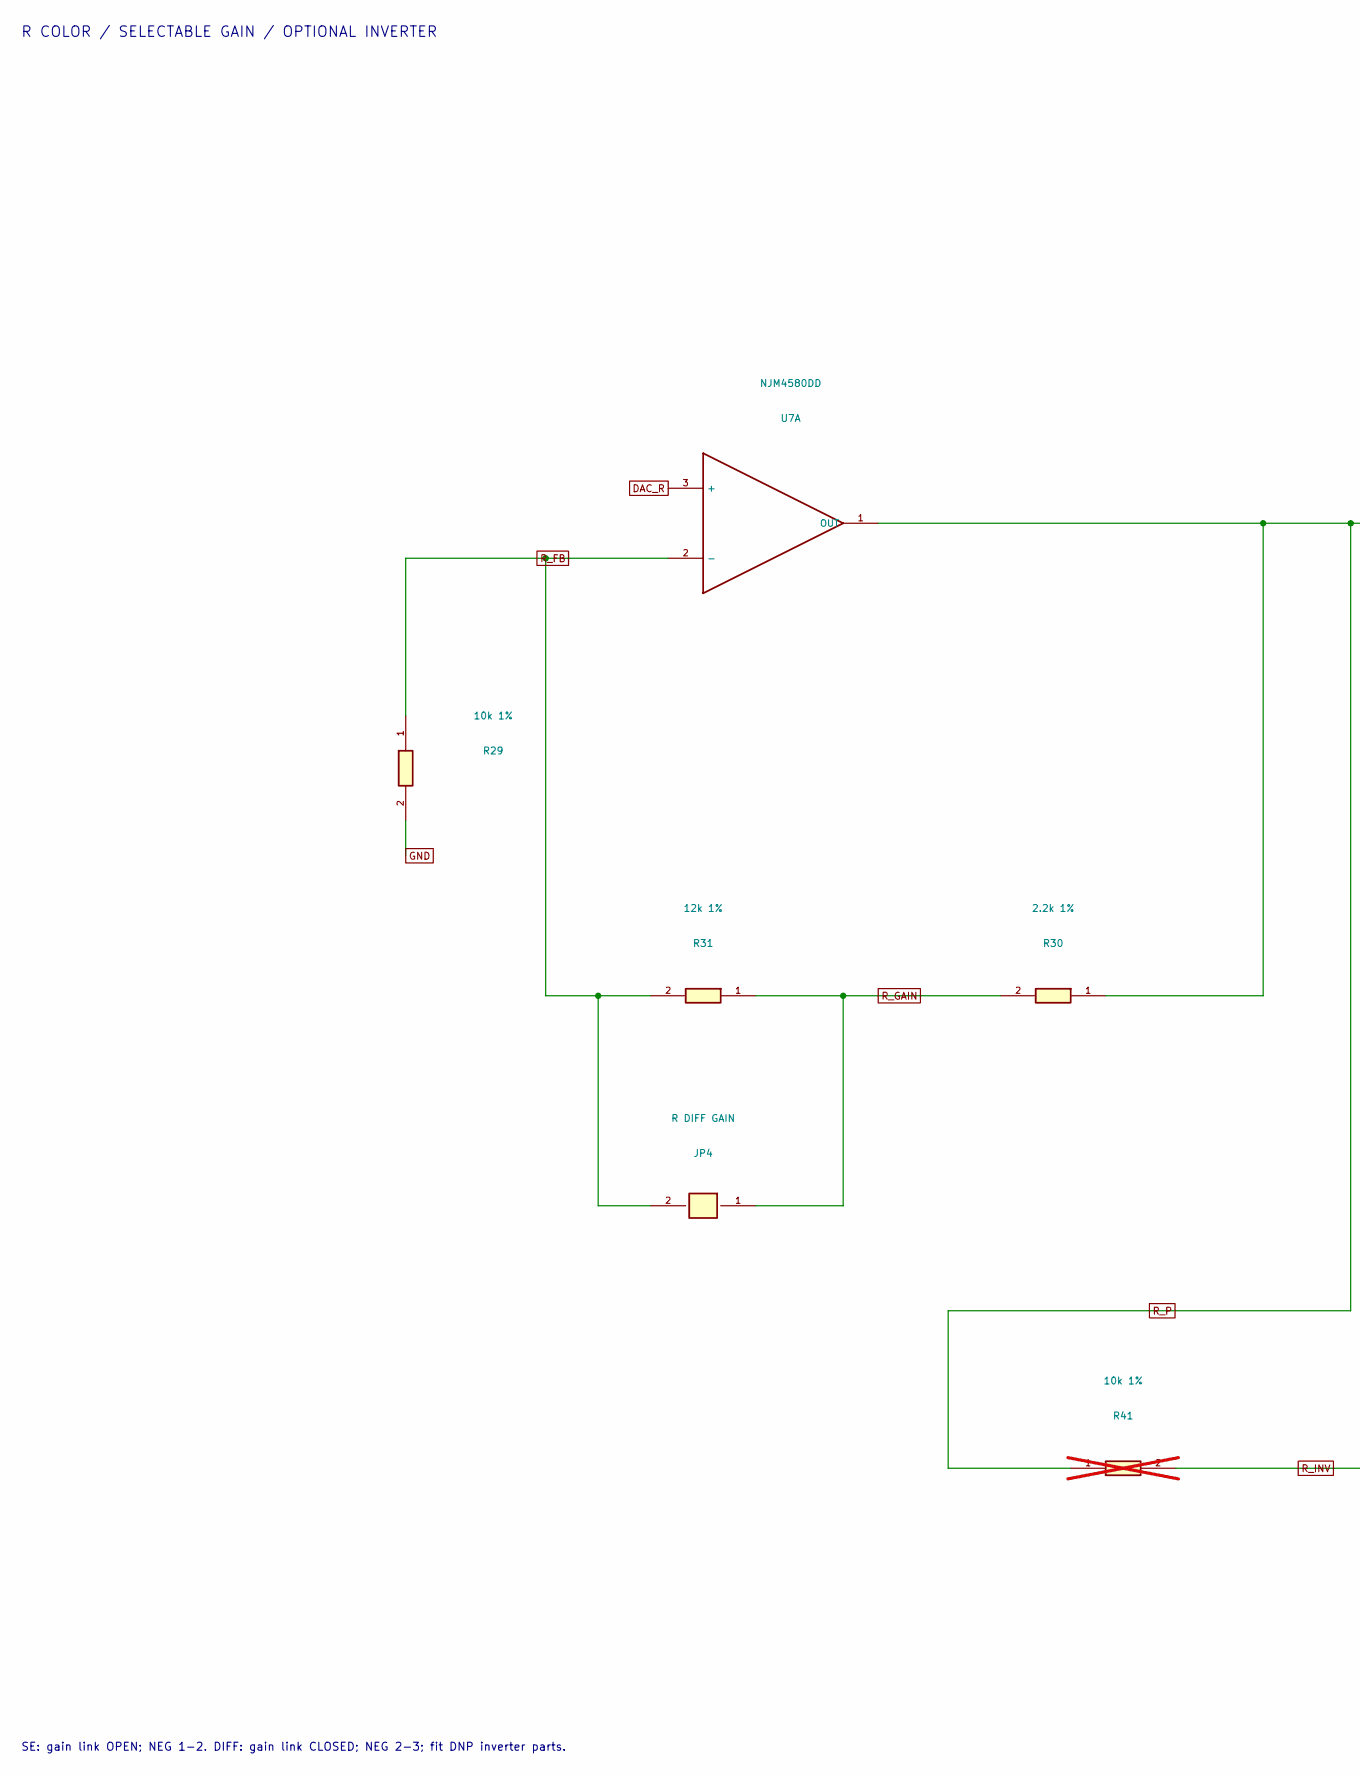
[picture p10: schematic 04_RGB_and_center_1.kicad_sch, R / Color driver and optional differential stage, part in row 1, column 1]

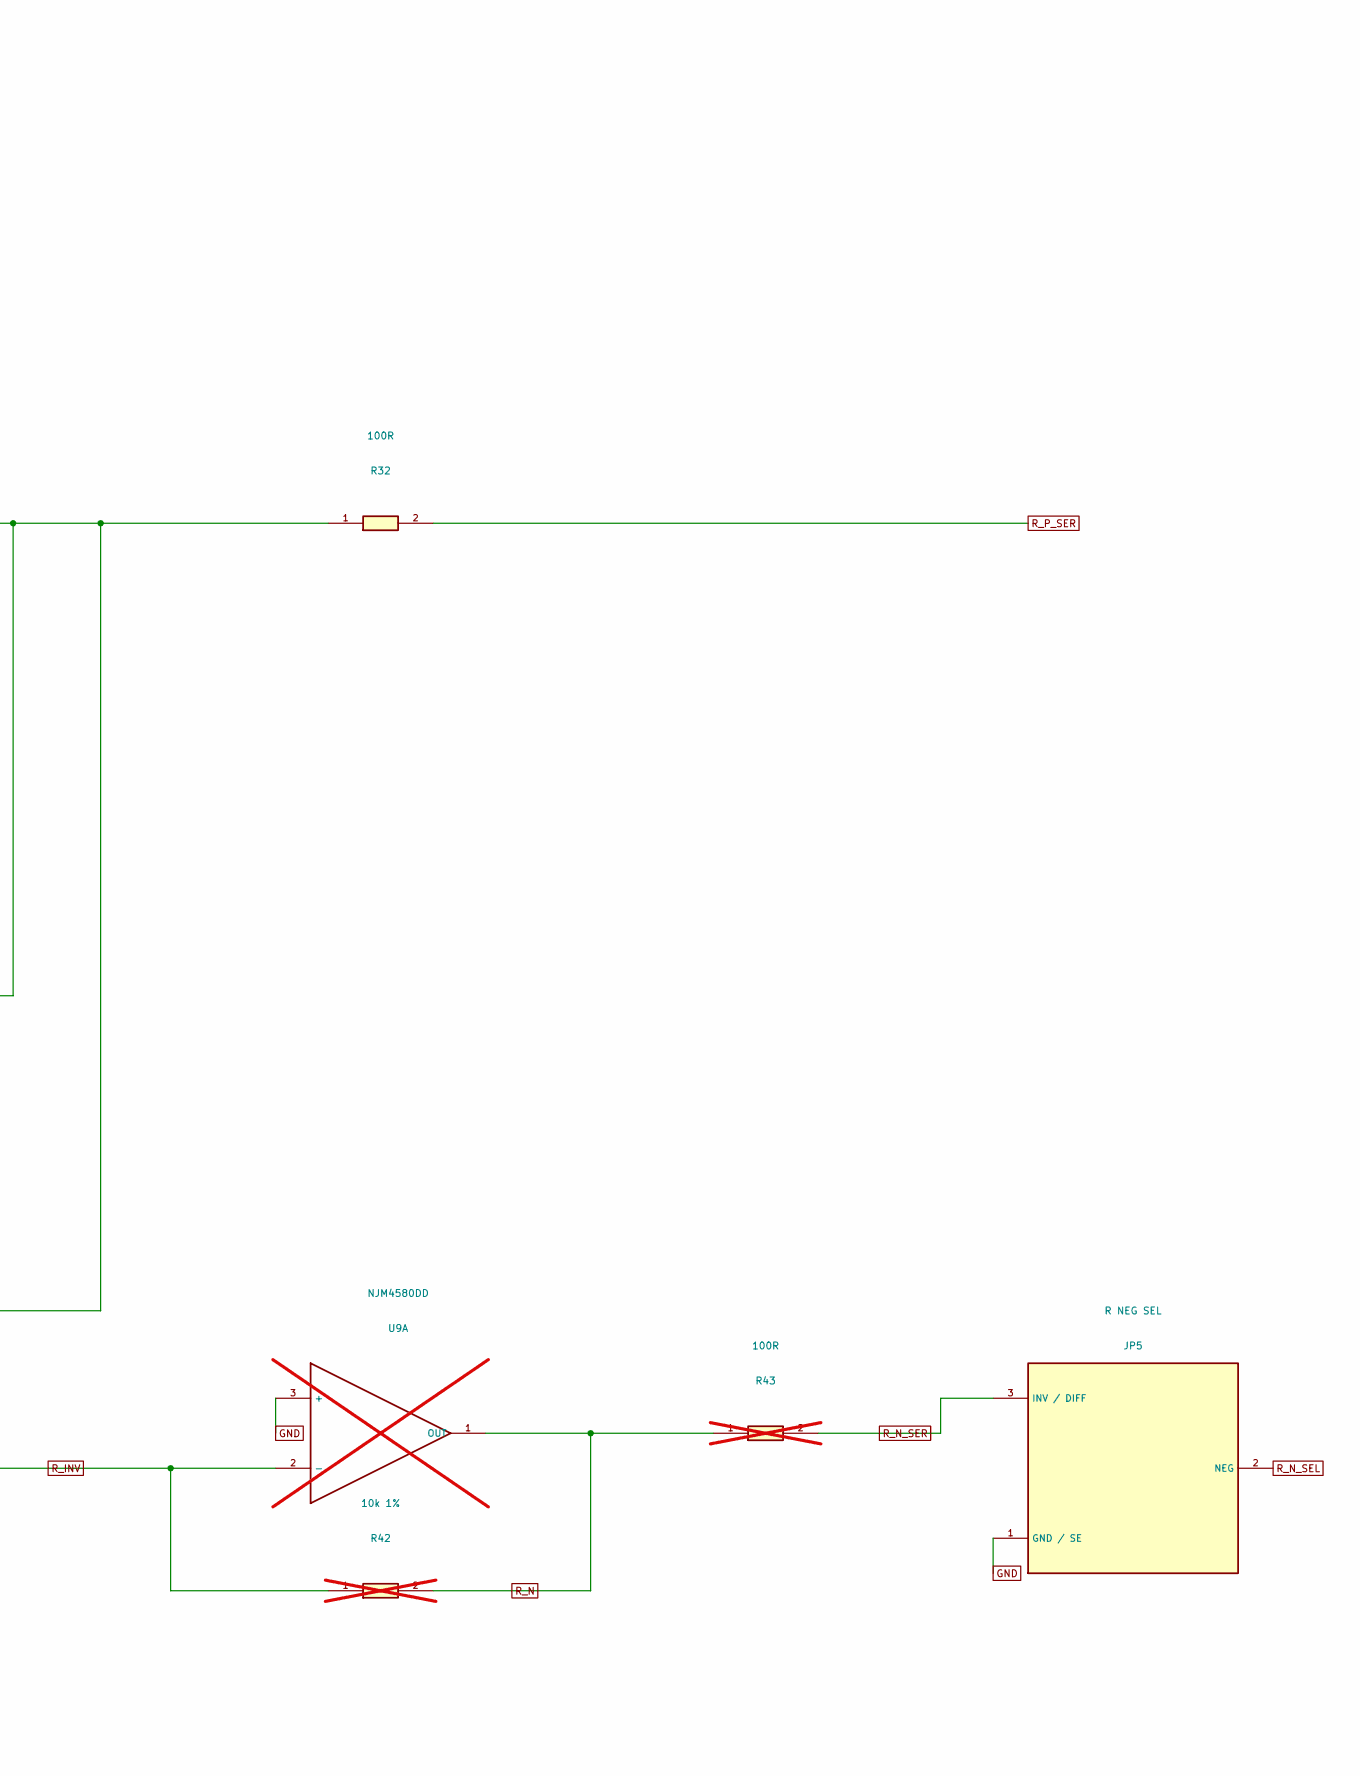
[picture p11: schematic 04_RGB_and_center_1.kicad_sch, R / Color driver and optional differential stage, part in row 1, column 2]

Parts:
JP4: R DIFF GAIN; PinHeader_1x02_P2.54mm_Vertical
JP5: R NEG SEL; PinHeader_1x03_P2.54mm_Vertical
R29: 10k 1%; R_Axial_DIN0207_L6.3mm_D2.5mm_P10.16mm_Horizontal
R30: 2.2k 1%; R_Axial_DIN0207_L6.3mm_D2.5mm_P10.16mm_Horizontal
R31: 12k 1%; R_Axial_DIN0207_L6.3mm_D2.5mm_P10.16mm_Horizontal
R32: 100R; R_Axial_DIN0207_L6.3mm_D2.5mm_P10.16mm_Horizontal
R41, R42: 10k 1%; R_Axial_DIN0207_L6.3mm_D2.5mm_P10.16mm_Horizontal; not fitted
R43: 100R; R_Axial_DIN0207_L6.3mm_D2.5mm_P10.16mm_Horizontal; not fitted
U7: NJM4580DD; DIP-8_W7.62mm
U9: NJM4580DD; DIP-8_W7.62mm; not fitted

Connections:
DAC_R: U7.3 (+); also elsewhere on the board
GND: JP5.1 (GND / SE), R29.2, U9.3 (+); also elsewhere on the board
R_FB: JP4.2, R29.1, R31.2, U7.2 (-)
R_GAIN: JP4.1, R30.2, R31.1
R_INV: R41.2, R42.1, U9.2 (-)
R_N: R42.2, R43.1, U9.1 (OUT)
R_N_SEL: JP5.2 (NEG); also elsewhere on the board
R_N_SER: JP5.3 (INV / DIFF), R43.2
R_P: R30.1, R32.1, R41.1, U7.1 (OUT)
R_P_SER: R32.2; also elsewhere on the board

Notes on the sheet:
R COLOR / SELECTABLE GAIN / OPTIONAL INVERTER
SE: gain link OPEN; NEG 1-2. DIFF: gain link CLOSED; NEG 2-3; fit DNP inverter parts.

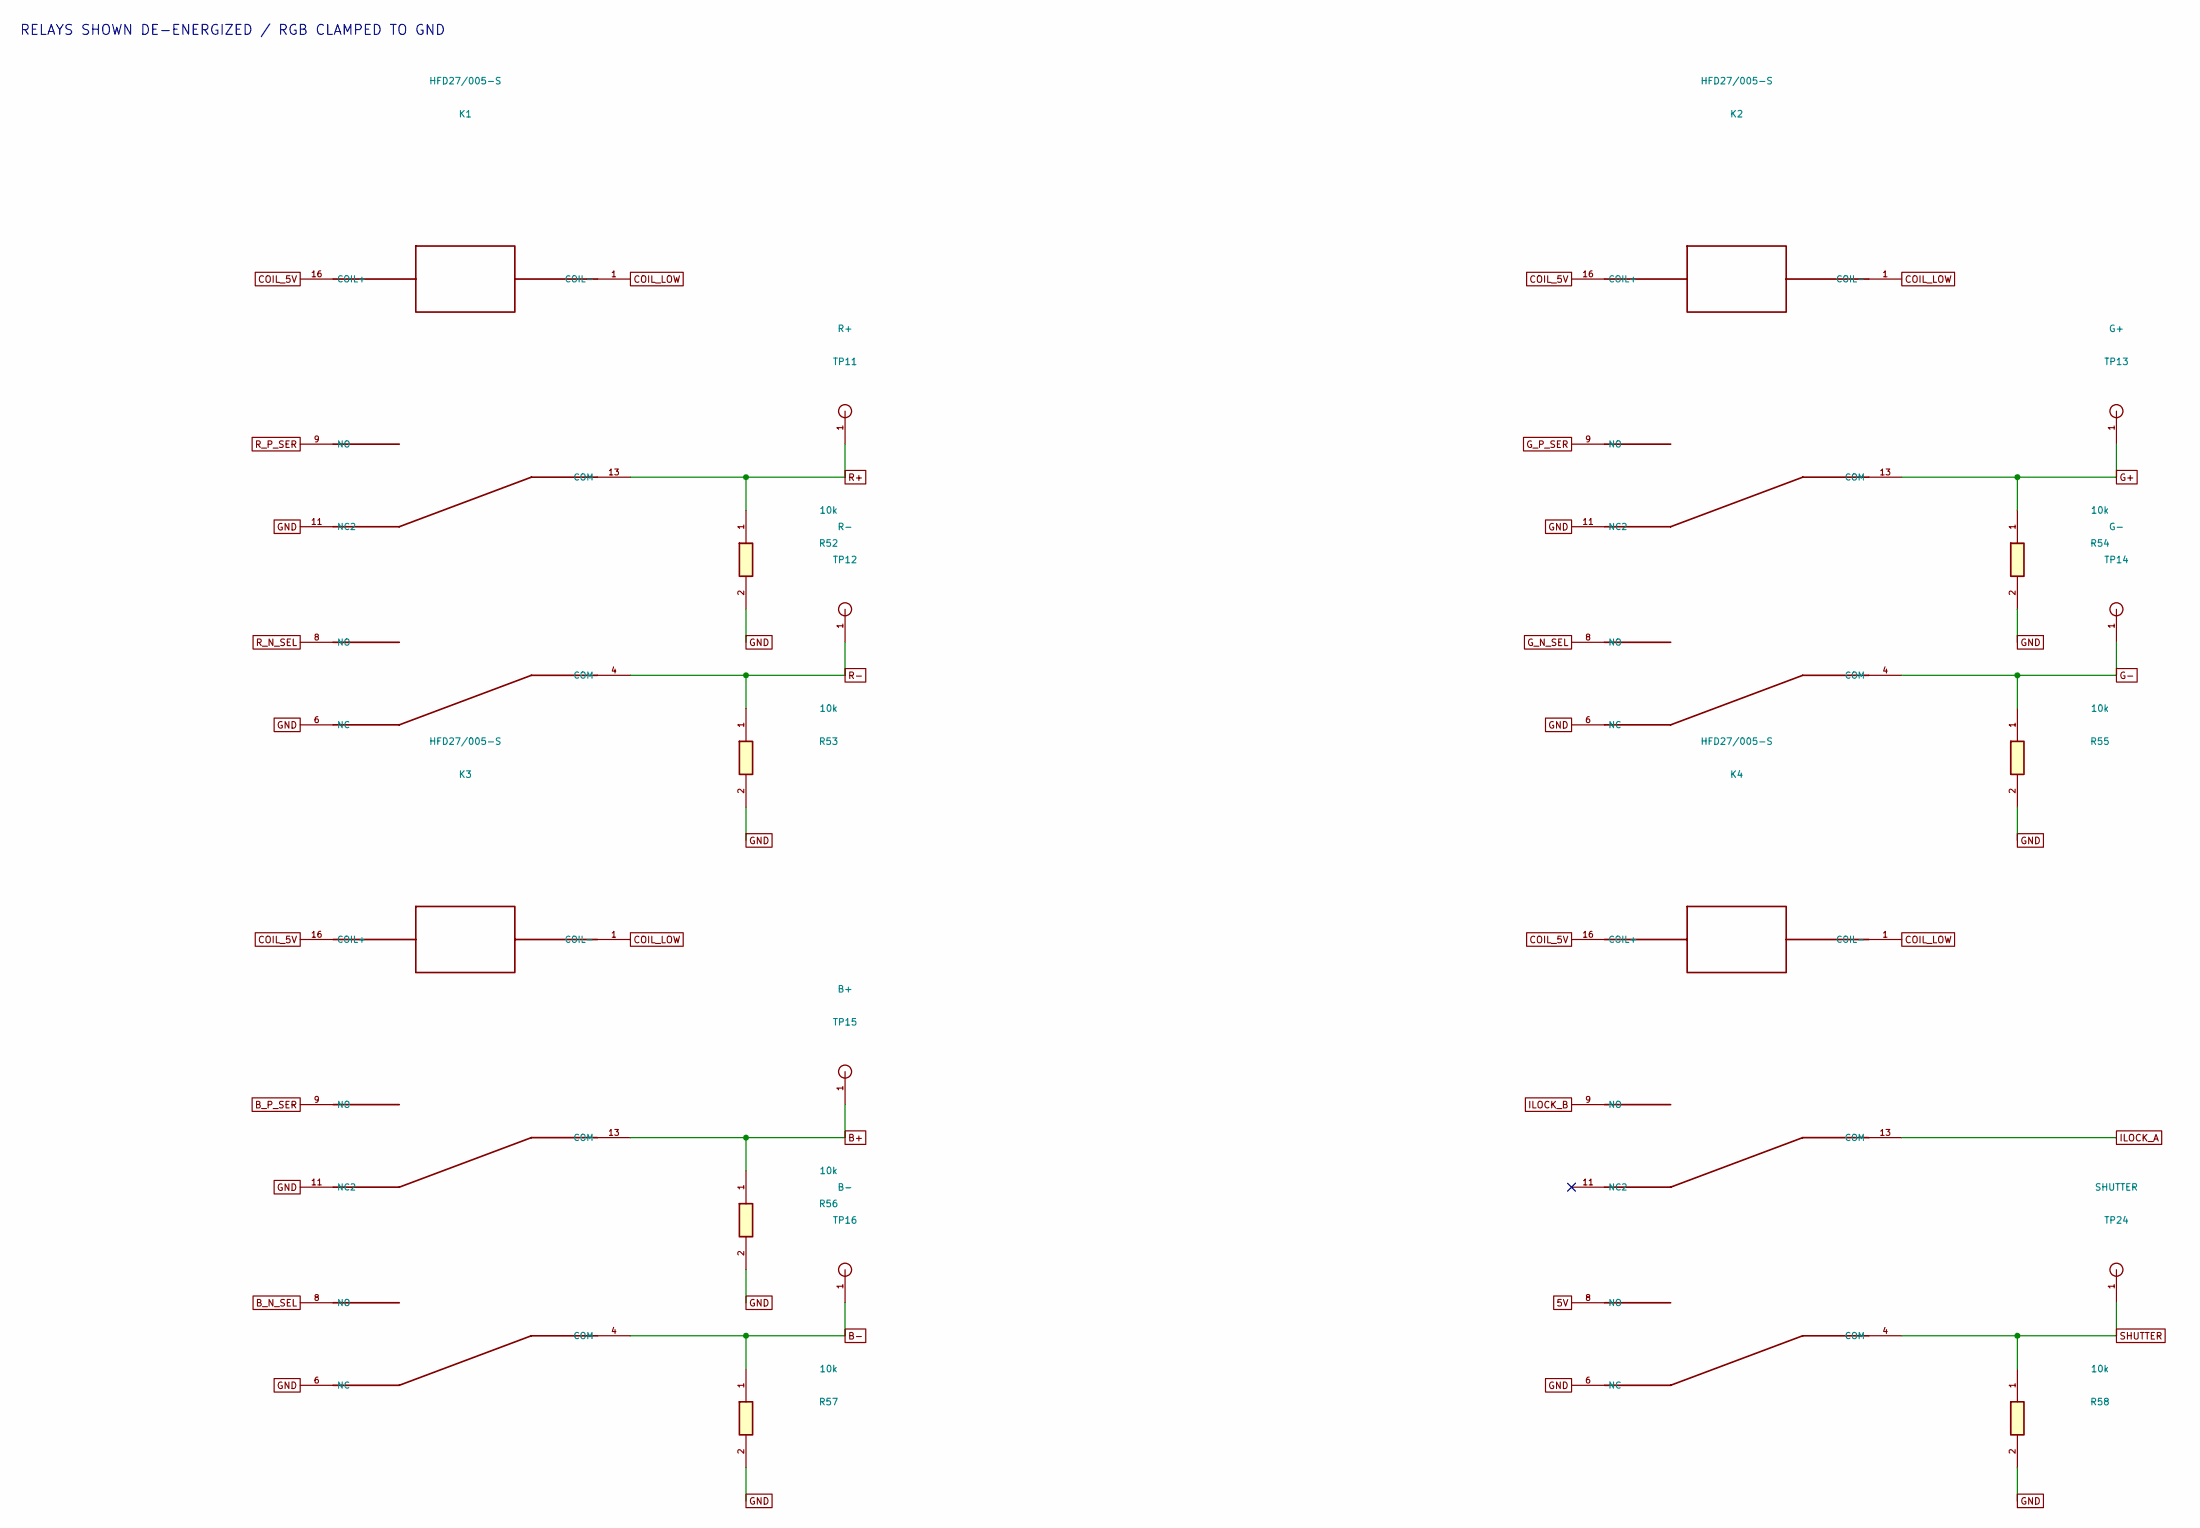
[picture p12: schematic 06_ARM_and_output_gating_2.kicad_sch, 11 / Fail-off relay contacts]

Parts:
K1, K2, K3, K4: HFD27/005-S; HFD27
R52, R53, R54, R55, R56, R57, R58: 10k; R_Axial_DIN0207_L6.3mm_D2.5mm_P10.16mm_Horizontal
TP11: R+; TestPoint_THTPad_D2.0mm_Drill1.0mm
TP12: R-; TestPoint_THTPad_D2.0mm_Drill1.0mm
TP13: G+; TestPoint_THTPad_D2.0mm_Drill1.0mm
TP14: G-; TestPoint_THTPad_D2.0mm_Drill1.0mm
TP15: B+; TestPoint_THTPad_D2.0mm_Drill1.0mm
TP16: B-; TestPoint_THTPad_D2.0mm_Drill1.0mm
TP24: SHUTTER; TestPoint_THTPad_D2.0mm_Drill1.0mm

Connections:
5V: K4.8 (NO); also elsewhere on the board
B+: K3.13 (COM), R56.1, TP15.1; also elsewhere on the board
B-: K3.4 (COM), R57.1, TP16.1; also elsewhere on the board
B_N_SEL: K3.8 (NO); also elsewhere on the board
B_P_SER: K3.9 (NO); also elsewhere on the board
COIL_5V: K1.16 (COIL+), K2.16 (COIL+), K3.16 (COIL+), K4.16 (COIL+); also elsewhere on the board
COIL_LOW: K1.1 (COIL-), K2.1 (COIL-), K3.1 (COIL-), K4.1 (COIL-); also elsewhere on the board
G+: K2.13 (COM), R54.1, TP13.1; also elsewhere on the board
G-: K2.4 (COM), R55.1, TP14.1; also elsewhere on the board
GND: K1.6 (NC), K1.11 (NC2), K2.6 (NC), K2.11 (NC2), K3.6 (NC), K3.11 (NC2), K4.6 (NC), R52.2, R53.2, R54.2, R55.2, R56.2, R57.2, R58.2; also elsewhere on the board
G_N_SEL: K2.8 (NO); also elsewhere on the board
G_P_SER: K2.9 (NO); also elsewhere on the board
ILOCK_A: K4.13 (COM); also elsewhere on the board
ILOCK_B: K4.9 (NO); also elsewhere on the board
R+: K1.13 (COM), R52.1, TP11.1; also elsewhere on the board
R-: K1.4 (COM), R53.1, TP12.1; also elsewhere on the board
R_N_SEL: K1.8 (NO); also elsewhere on the board
R_P_SER: K1.9 (NO); also elsewhere on the board
SHUTTER: K4.4 (COM), R58.1, TP24.1; also elsewhere on the board

Notes on the sheet:
RELAYS SHOWN DE-ENERGIZED / RGB CLAMPED TO GND

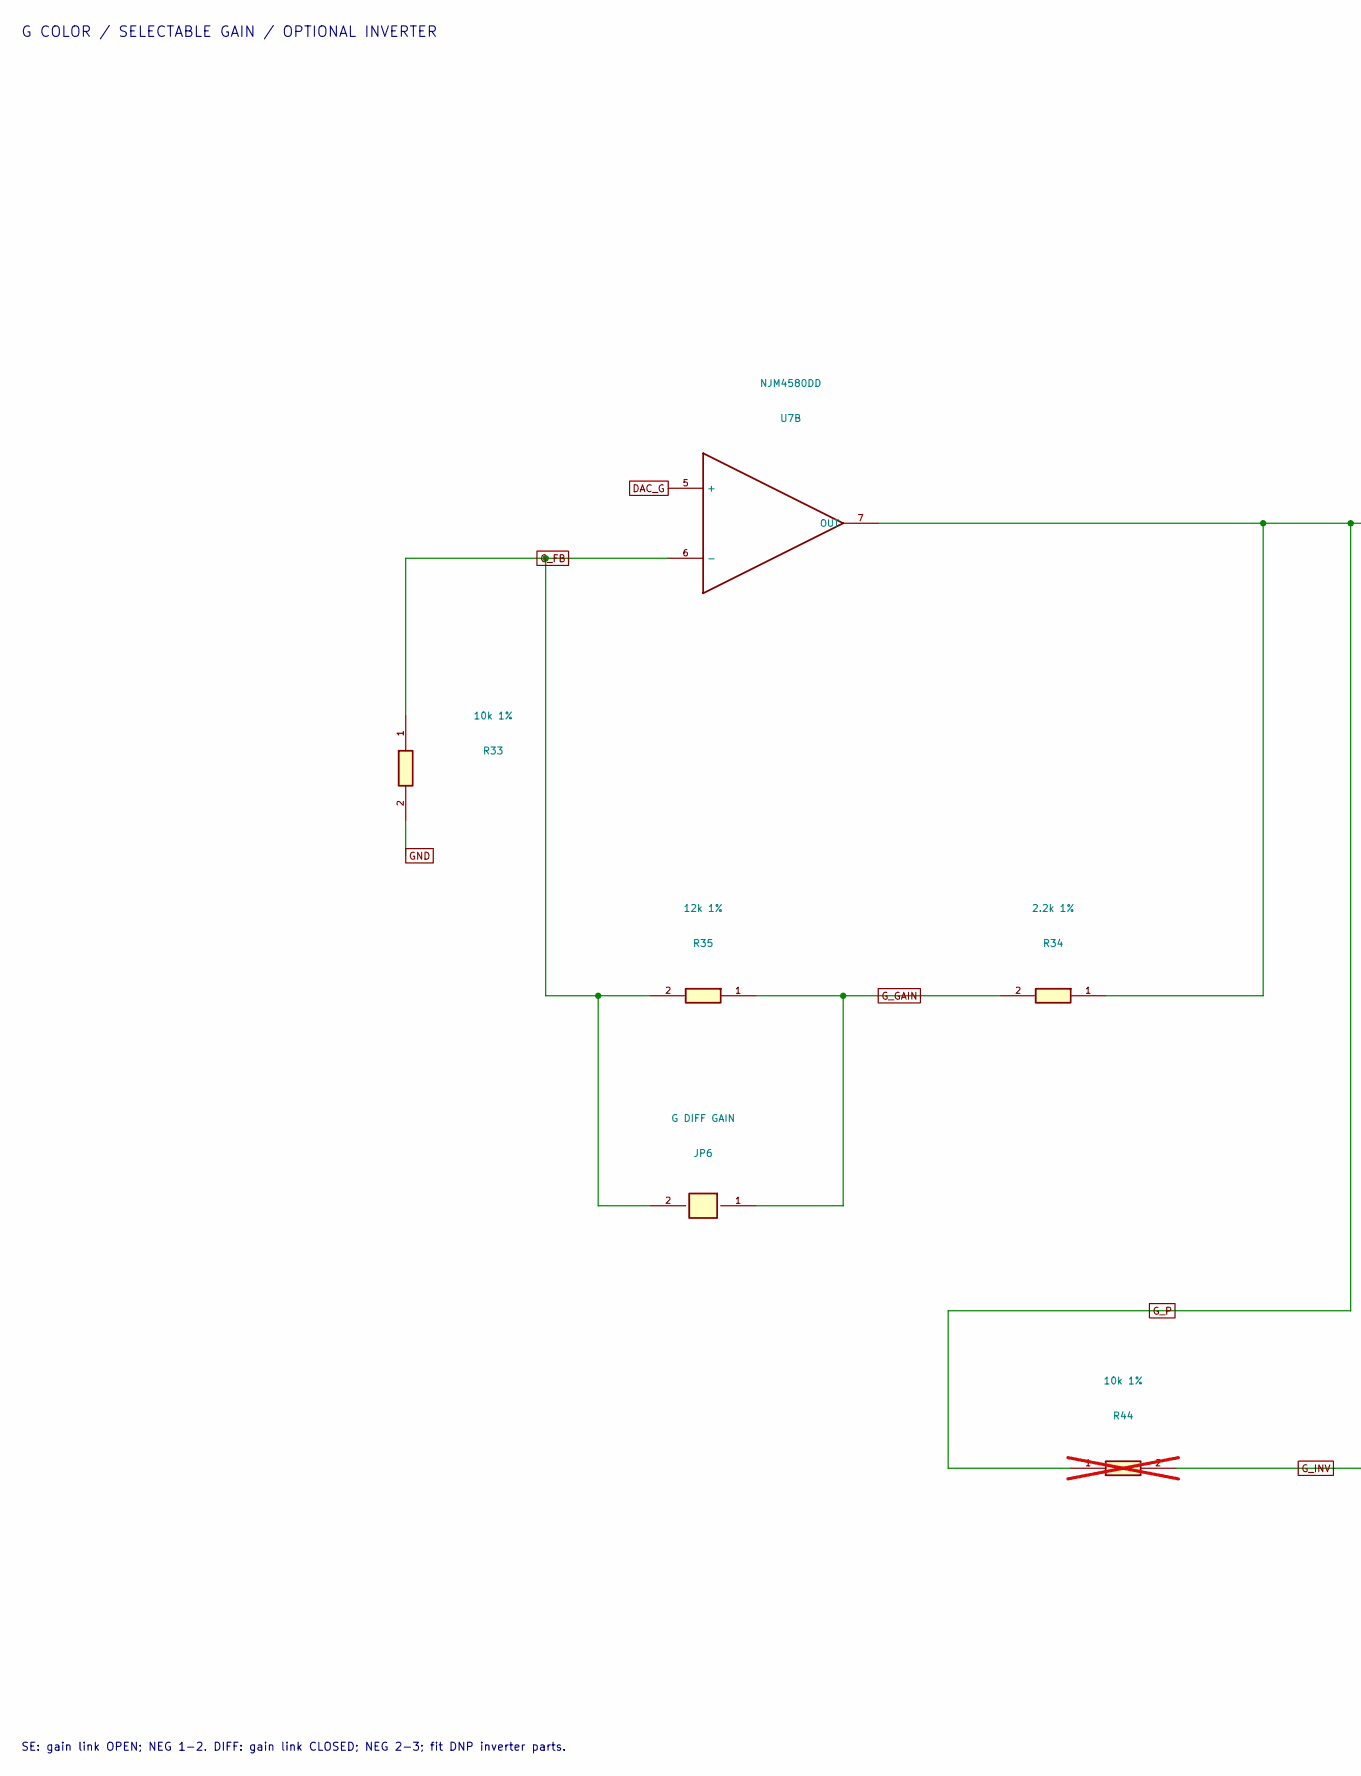
[picture p13: schematic 04_RGB_and_center_2.kicad_sch, G / Color driver and optional differential stage, part in row 1, column 1]

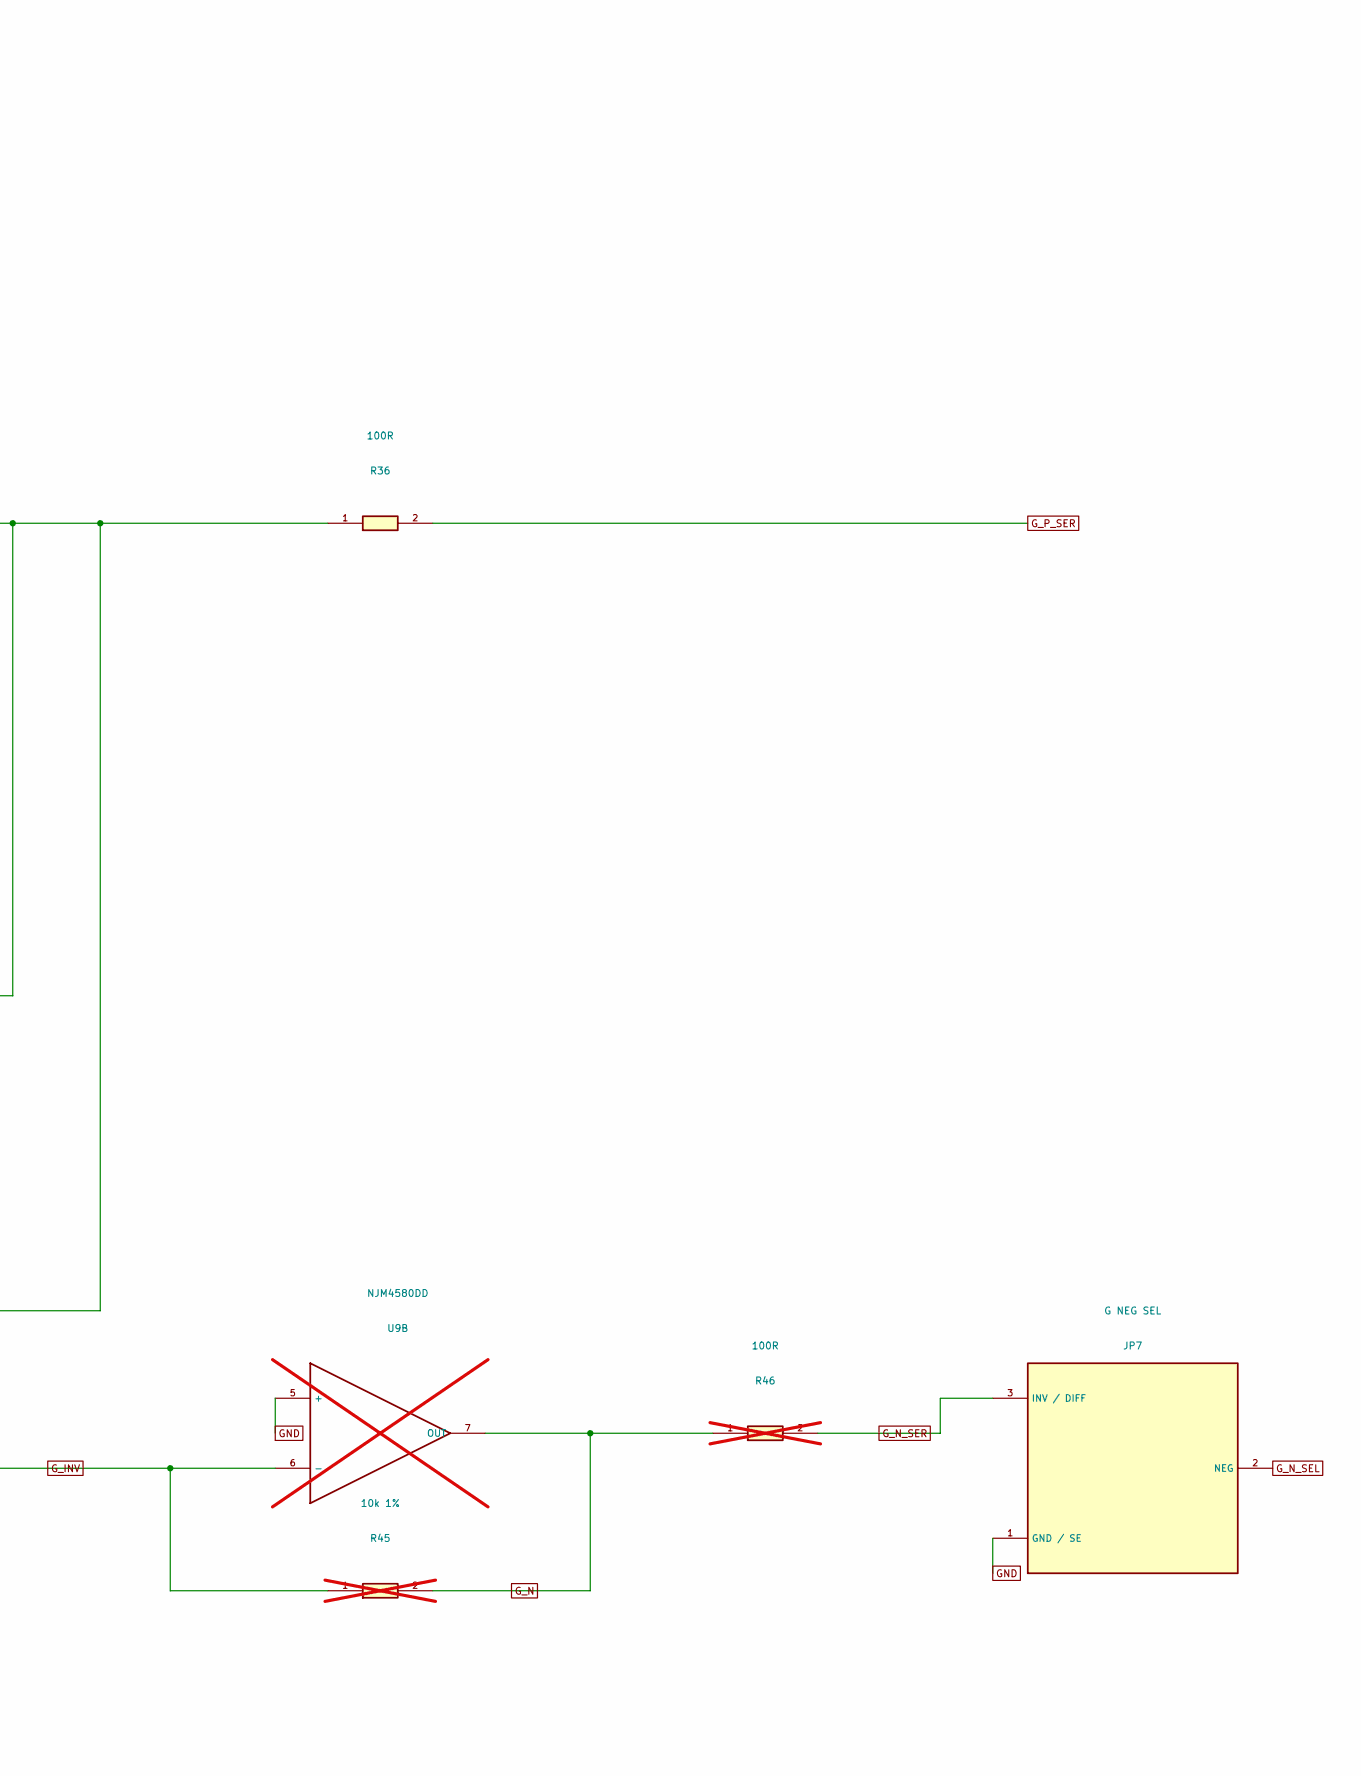
[picture p14: schematic 04_RGB_and_center_2.kicad_sch, G / Color driver and optional differential stage, part in row 1, column 2]

Parts:
JP6: G DIFF GAIN; PinHeader_1x02_P2.54mm_Vertical
JP7: G NEG SEL; PinHeader_1x03_P2.54mm_Vertical
R33: 10k 1%; R_Axial_DIN0207_L6.3mm_D2.5mm_P10.16mm_Horizontal
R34: 2.2k 1%; R_Axial_DIN0207_L6.3mm_D2.5mm_P10.16mm_Horizontal
R35: 12k 1%; R_Axial_DIN0207_L6.3mm_D2.5mm_P10.16mm_Horizontal
R36: 100R; R_Axial_DIN0207_L6.3mm_D2.5mm_P10.16mm_Horizontal
R44, R45: 10k 1%; R_Axial_DIN0207_L6.3mm_D2.5mm_P10.16mm_Horizontal; not fitted
R46: 100R; R_Axial_DIN0207_L6.3mm_D2.5mm_P10.16mm_Horizontal; not fitted
U7: NJM4580DD; DIP-8_W7.62mm
U9: NJM4580DD; DIP-8_W7.62mm; not fitted

Connections:
DAC_G: U7.5 (+); also elsewhere on the board
GND: JP7.1 (GND / SE), R33.2, U9.5 (+); also elsewhere on the board
G_FB: JP6.2, R33.1, R35.2, U7.6 (-)
G_GAIN: JP6.1, R34.2, R35.1
G_INV: R44.2, R45.1, U9.6 (-)
G_N: R45.2, R46.1, U9.7 (OUT)
G_N_SEL: JP7.2 (NEG); also elsewhere on the board
G_N_SER: JP7.3 (INV / DIFF), R46.2
G_P: R34.1, R36.1, R44.1, U7.7 (OUT)
G_P_SER: R36.2; also elsewhere on the board

Notes on the sheet:
G COLOR / SELECTABLE GAIN / OPTIONAL INVERTER
SE: gain link OPEN; NEG 1-2. DIFF: gain link CLOSED; NEG 2-3; fit DNP inverter parts.
