TakuroFukamizu/cores3-ilda/hardware/rev-a/kicad/CoreS3_ILDA_RevA.kicad_pcb

## KiCad design hardware/rev-a/kicad/CoreS3_ILDA_RevA.kicad_pcb (continued)

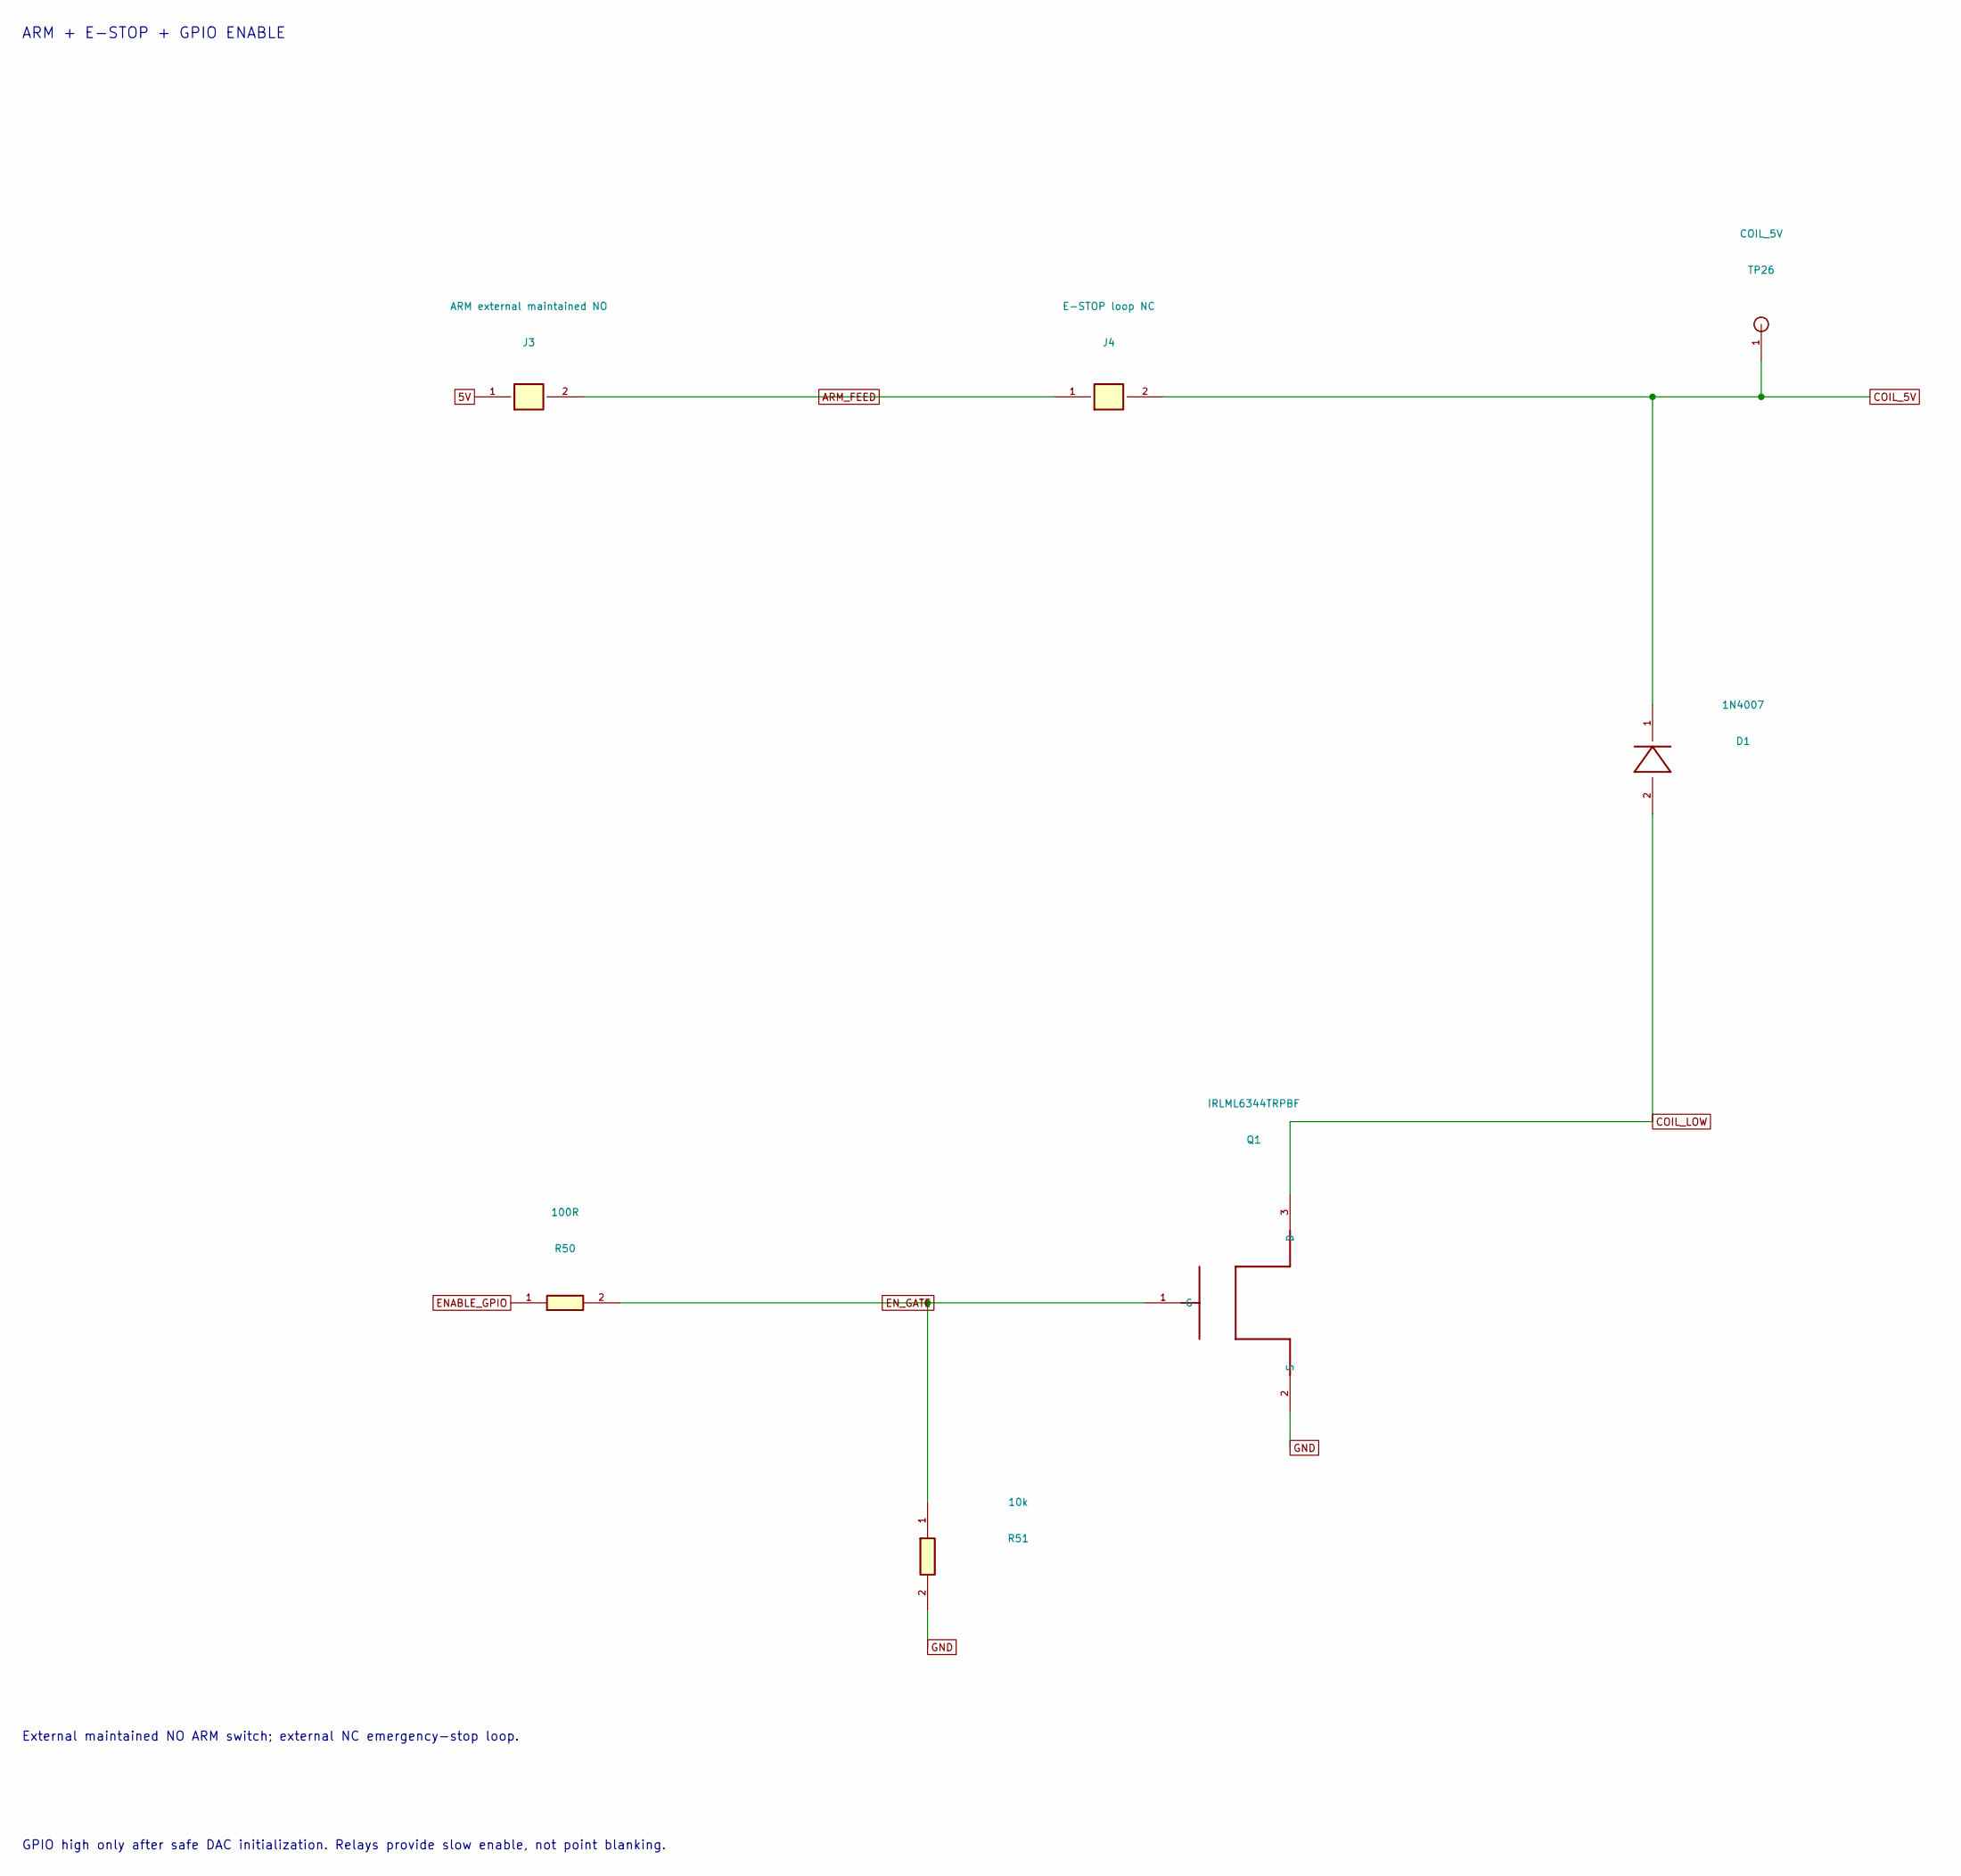
[picture p15: schematic 06_ARM_and_output_gating_1.kicad_sch, 10 / Manual ARM and relay driver]

Parts:
D1: 1N4007; D_DO-41_SOD81_P10.16mm_Horizontal
J3: ARM external maintained NO; TerminalBlock_Phoenix_MKDS-1,5-2_1x02_P5.00mm_Horizontal
J4: E-STOP loop NC; TerminalBlock_Phoenix_MKDS-1,5-2_1x02_P5.00mm_Horizontal
Q1: IRLML6344TRPBF; SOT-23
R50: 100R; R_Axial_DIN0207_L6.3mm_D2.5mm_P10.16mm_Horizontal
R51: 10k; R_Axial_DIN0207_L6.3mm_D2.5mm_P10.16mm_Horizontal
TP26: COIL_5V; TestPoint_THTPad_D2.0mm_Drill1.0mm

Connections:
5V: J3.1; also elsewhere on the board
ARM_FEED: J3.2, J4.1
COIL_5V: D1.1, J4.2, TP26.1; also elsewhere on the board
COIL_LOW: D1.2, Q1.3 (D); also elsewhere on the board
ENABLE_GPIO: R50.1; also elsewhere on the board
EN_GATE: Q1.1 (G), R50.2, R51.1
GND: Q1.2 (S), R51.2; also elsewhere on the board

Notes on the sheet:
ARM + E-STOP + GPIO ENABLE
External maintained NO ARM switch; external NC emergency-stop loop.
GPIO high only after safe DAC initialization. Relays provide slow enable, not point blanking.

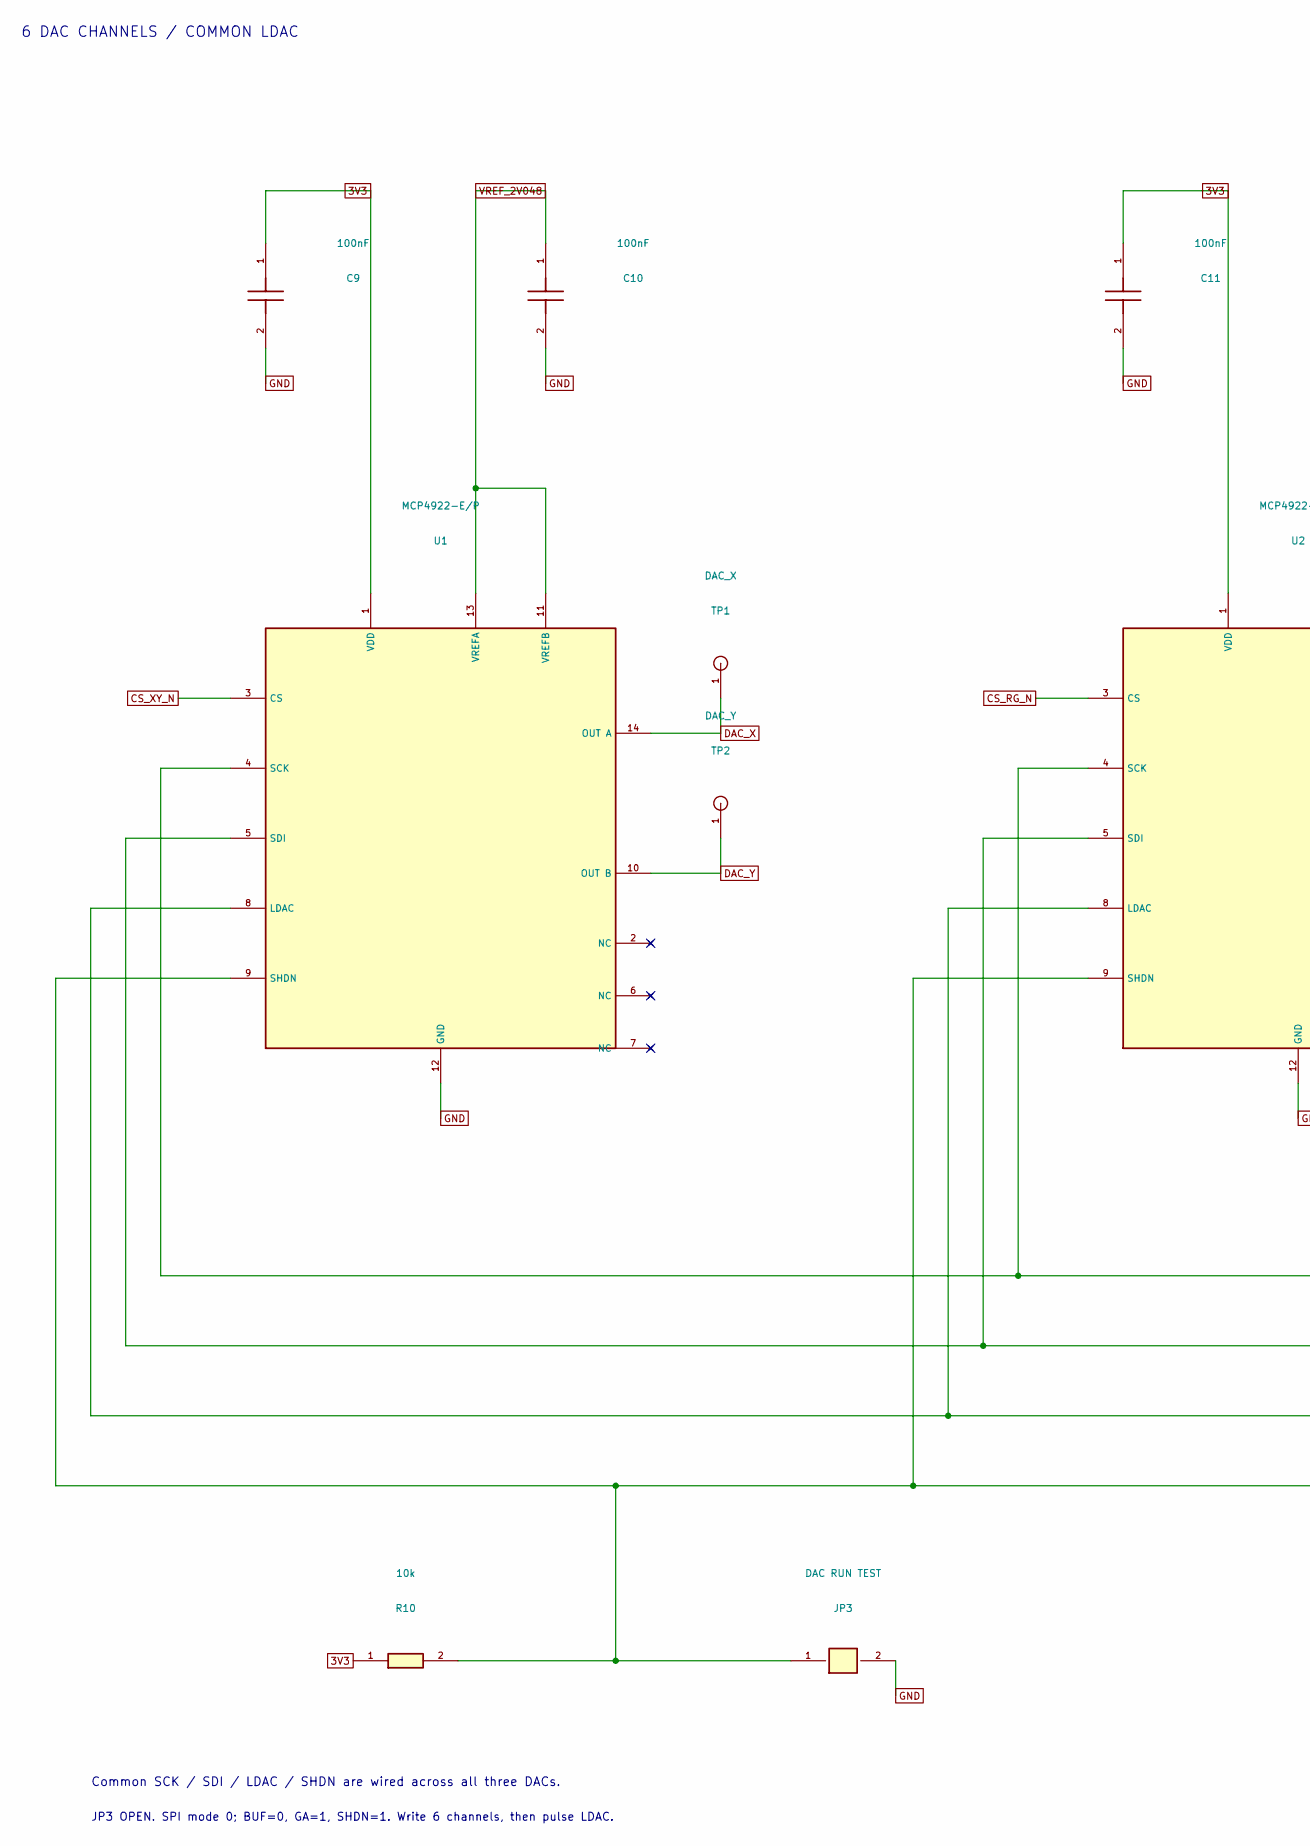
[picture p16: schematic 02_DAC_and_reference_2.kicad_sch, 04 / Six-channel DAC bank, part in row 1, column 1]

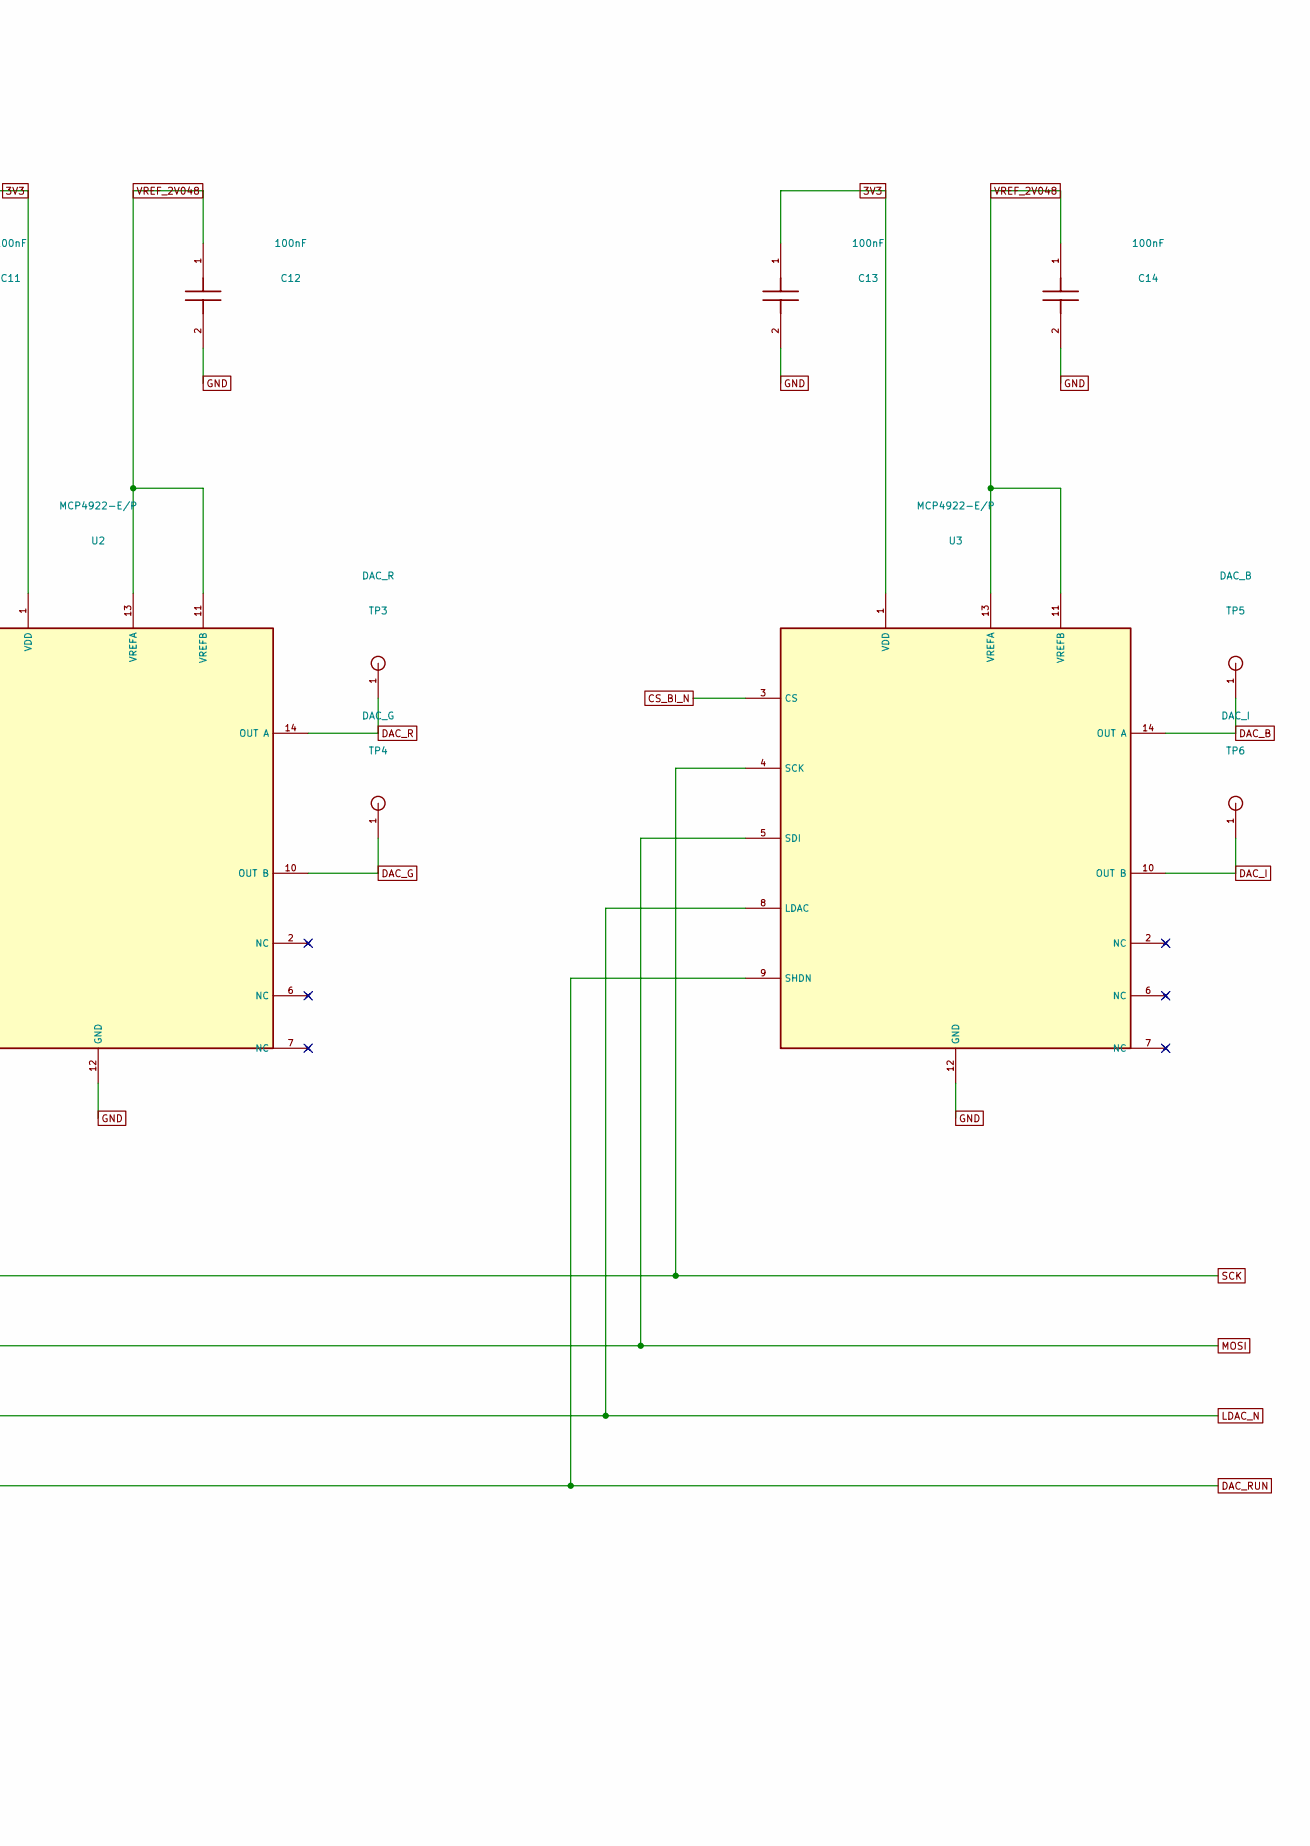
[picture p17: schematic 02_DAC_and_reference_2.kicad_sch, 04 / Six-channel DAC bank, part in row 1, column 2]

Parts:
C9, C10, C11, C12, C13, C14: 100nF; C_Disc_D5.0mm_W2.5mm_P5.00mm
JP3: DAC RUN TEST; PinHeader_1x02_P2.54mm_Vertical
R10: 10k; R_Axial_DIN0207_L6.3mm_D2.5mm_P10.16mm_Horizontal
TP1: DAC_X; TestPoint_THTPad_D2.0mm_Drill1.0mm
TP2: DAC_Y; TestPoint_THTPad_D2.0mm_Drill1.0mm
TP3: DAC_R; TestPoint_THTPad_D2.0mm_Drill1.0mm
TP4: DAC_G; TestPoint_THTPad_D2.0mm_Drill1.0mm
TP5: DAC_B; TestPoint_THTPad_D2.0mm_Drill1.0mm
TP6: DAC_I; TestPoint_THTPad_D2.0mm_Drill1.0mm
U1, U2, U3: MCP4922-E/P; DIP-14_W7.62mm

Connections:
3V3: C9.1, C11.1, C13.1, R10.1, U1.1 (VDD), U2.1 (VDD), U3.1 (VDD); also elsewhere on the board
CS_BI_N: U3.3 (CS); also elsewhere on the board
CS_RG_N: U2.3 (CS); also elsewhere on the board
CS_XY_N: U1.3 (CS); also elsewhere on the board
DAC_B: TP5.1, U3.14 (OUT A); also elsewhere on the board
DAC_G: TP4.1, U2.10 (OUT B); also elsewhere on the board
DAC_I: TP6.1, U3.10 (OUT B); also elsewhere on the board
DAC_R: TP3.1, U2.14 (OUT A); also elsewhere on the board
DAC_RUN: JP3.1, R10.2, U1.9 (SHDN), U2.9 (SHDN), U3.9 (SHDN)
DAC_X: TP1.1, U1.14 (OUT A); also elsewhere on the board
DAC_Y: TP2.1, U1.10 (OUT B); also elsewhere on the board
GND: C9.2, C10.2, C11.2, C12.2, C13.2, C14.2, JP3.2, U1.12 (GND), U2.12 (GND), U3.12 (GND); also elsewhere on the board
LDAC_N: U1.8 (LDAC), U2.8 (LDAC), U3.8 (LDAC); also elsewhere on the board
MOSI: U1.5 (SDI), U2.5 (SDI), U3.5 (SDI); also elsewhere on the board
SCK: U1.4 (SCK), U2.4 (SCK), U3.4 (SCK); also elsewhere on the board
VREF_2V048: C10.1, C12.1, C14.1, U1.11 (VREFB), U1.13 (VREFA), U2.11 (VREFB), U2.13 (VREFA), U3.11 (VREFB), U3.13 (VREFA); also elsewhere on the board

Notes on the sheet:
6 DAC CHANNELS / COMMON LDAC
Common SCK / SDI / LDAC / SHDN are wired across all three DACs.
JP3 OPEN. SPI mode 0; BUF=0, GA=1, SHDN=1. Write 6 channels, then pulse LDAC.

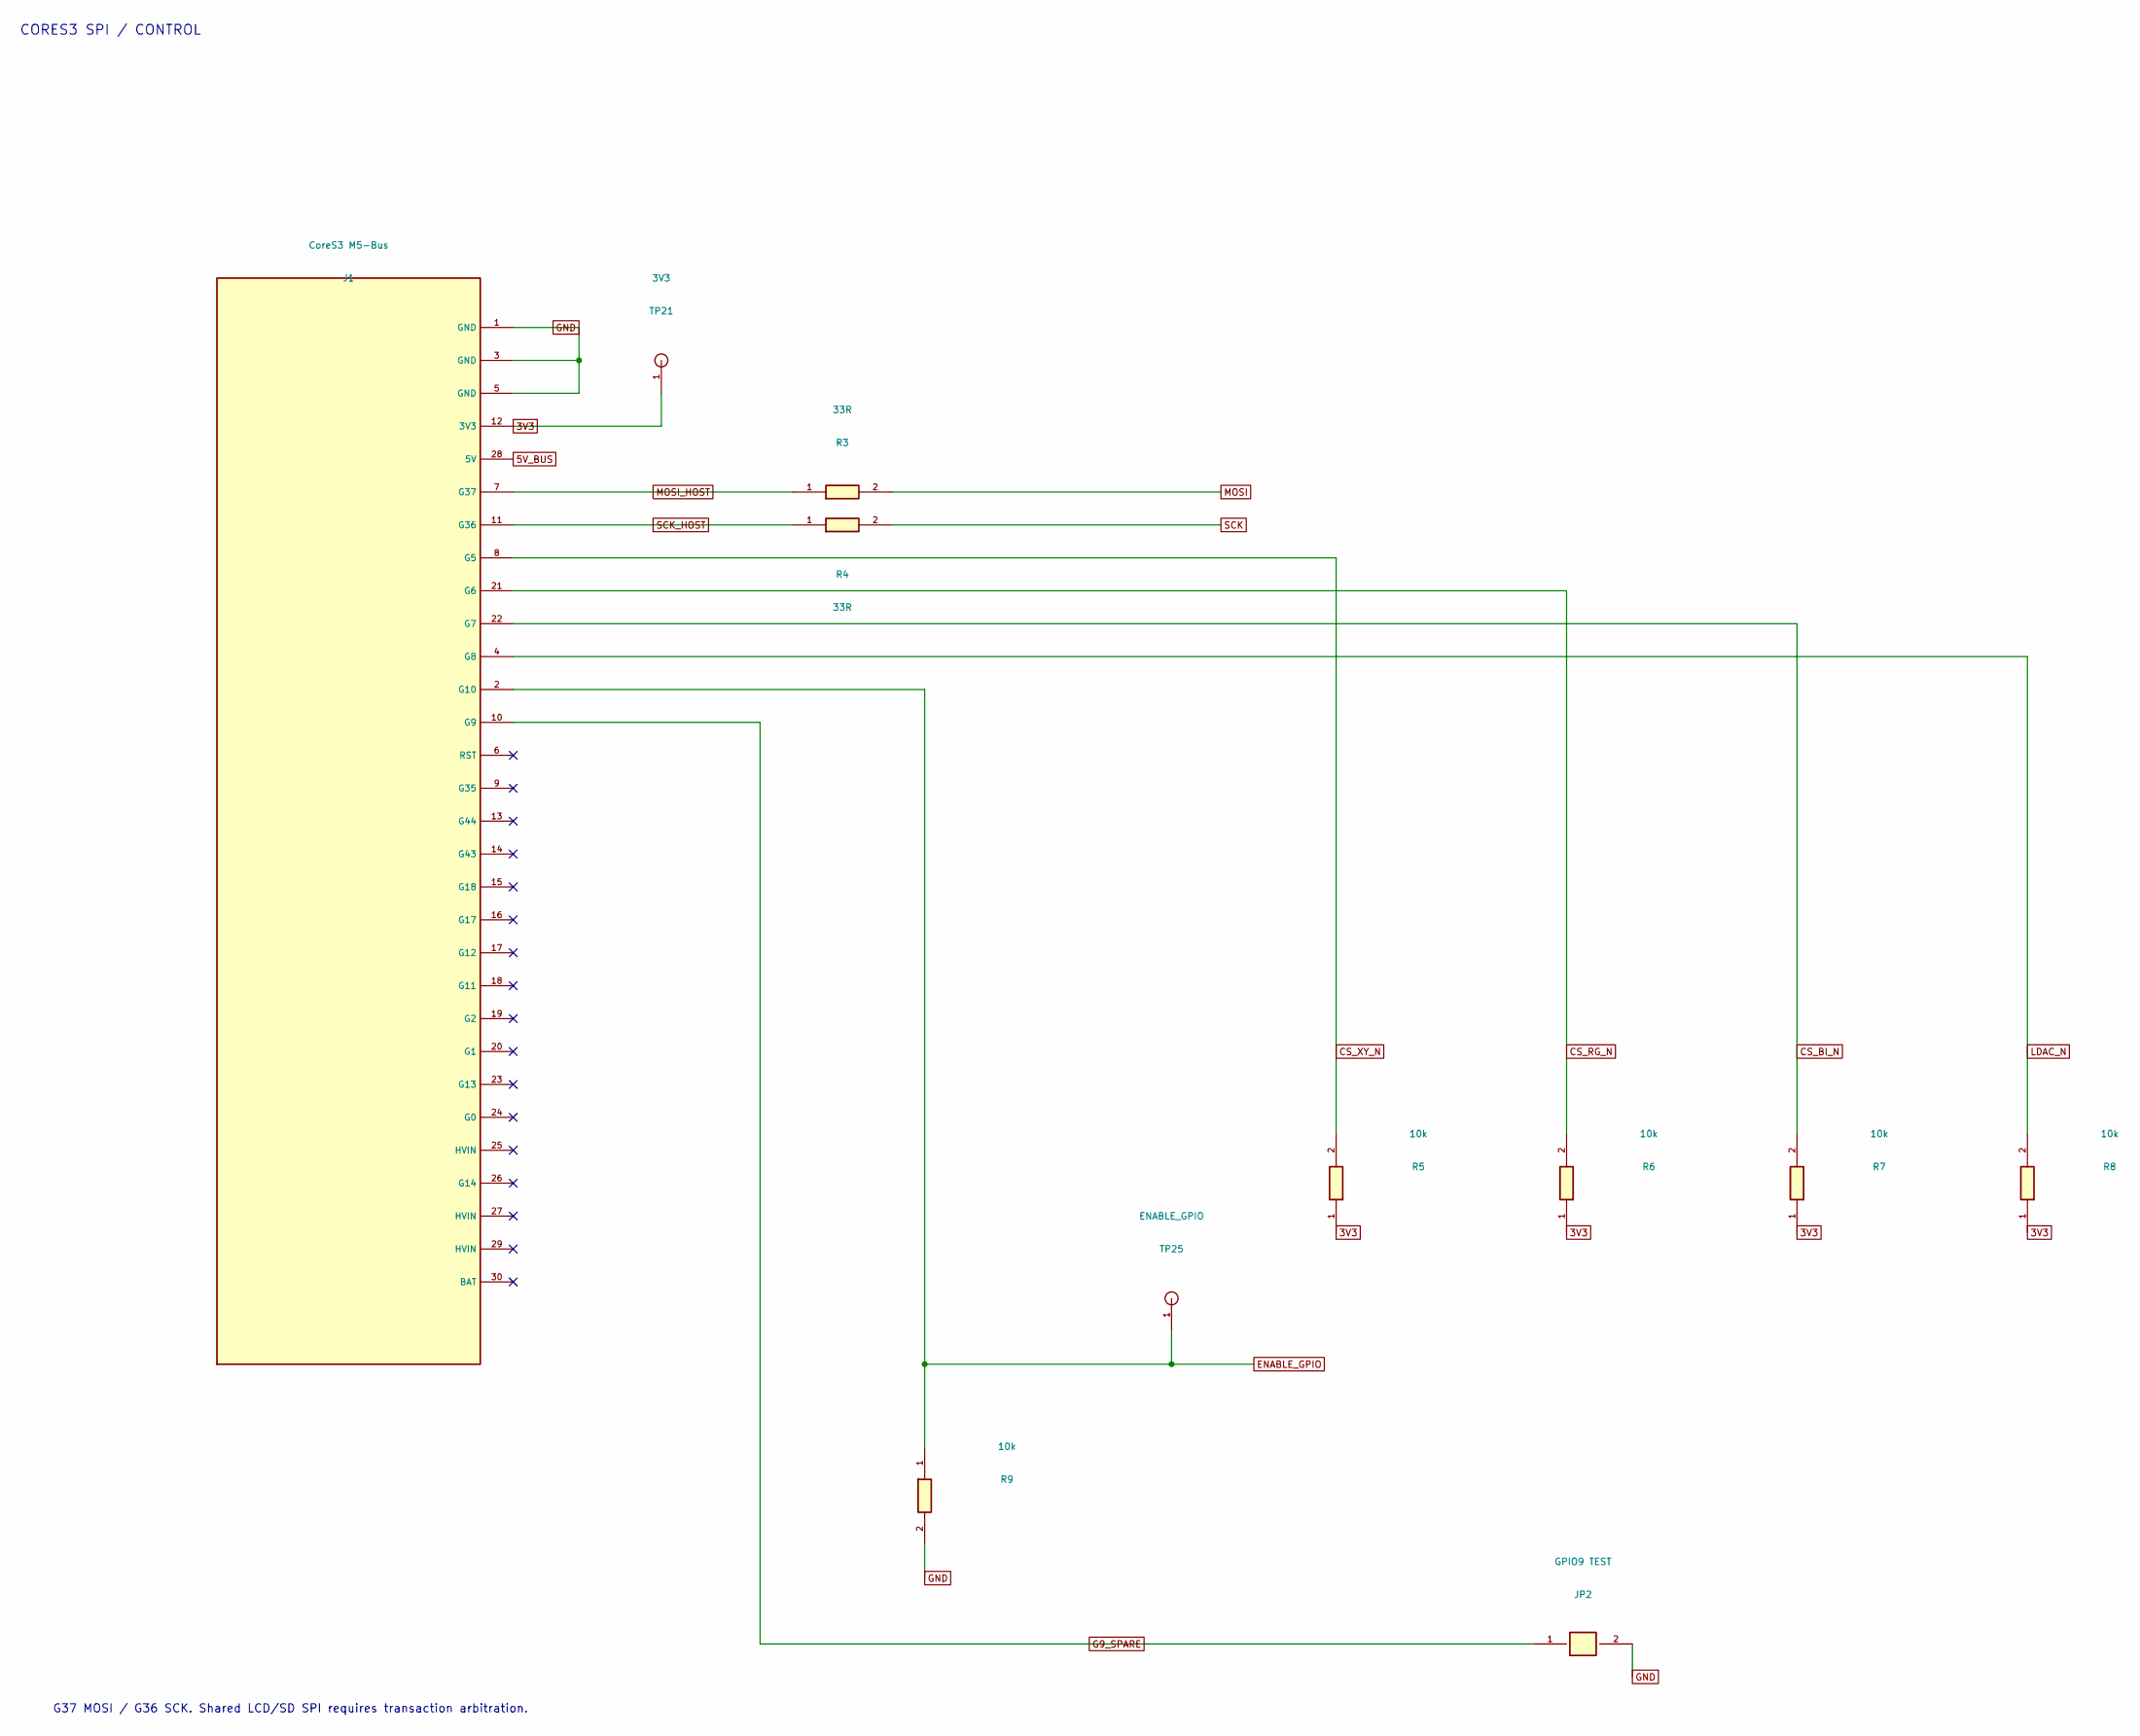
[picture p18: schematic 01_Host_and_power_2.kicad_sch, 02 / CoreS3 bus and digital control]

Parts:
J1: CoreS3 M5-Bus; M5Bus_CoreS3_TypeA
JP2: GPIO9 TEST; PinHeader_1x02_P2.54mm_Vertical
R3, R4: 33R; R_Axial_DIN0207_L6.3mm_D2.5mm_P10.16mm_Horizontal
R5, R6, R7, R8, R9: 10k; R_Axial_DIN0207_L6.3mm_D2.5mm_P10.16mm_Horizontal
TP21: 3V3; TestPoint_THTPad_D2.0mm_Drill1.0mm
TP25: ENABLE_GPIO; TestPoint_THTPad_D2.0mm_Drill1.0mm

Connections:
3V3: J1.12 (3V3), R5.1, R6.1, R7.1, R8.1, TP21.1; also elsewhere on the board
5V_BUS: J1.28 (5V); also elsewhere on the board
CS_BI_N: J1.22 (G7), R7.2; also elsewhere on the board
CS_RG_N: J1.21 (G6), R6.2; also elsewhere on the board
CS_XY_N: J1.8 (G5), R5.2; also elsewhere on the board
ENABLE_GPIO: J1.2 (G10), R9.1, TP25.1; also elsewhere on the board
G9_SPARE: J1.10 (G9), JP2.1
GND: J1.1 (GND), J1.3 (GND), J1.5 (GND), JP2.2, R9.2; also elsewhere on the board
LDAC_N: J1.4 (G8), R8.2; also elsewhere on the board
MOSI: R3.2; also elsewhere on the board
MOSI_HOST: J1.7 (G37), R3.1
SCK: R4.2; also elsewhere on the board
SCK_HOST: J1.11 (G36), R4.1

Notes on the sheet:
CORES3 SPI / CONTROL
G37 MOSI / G36 SCK. Shared LCD/SD SPI requires transaction arbitration.

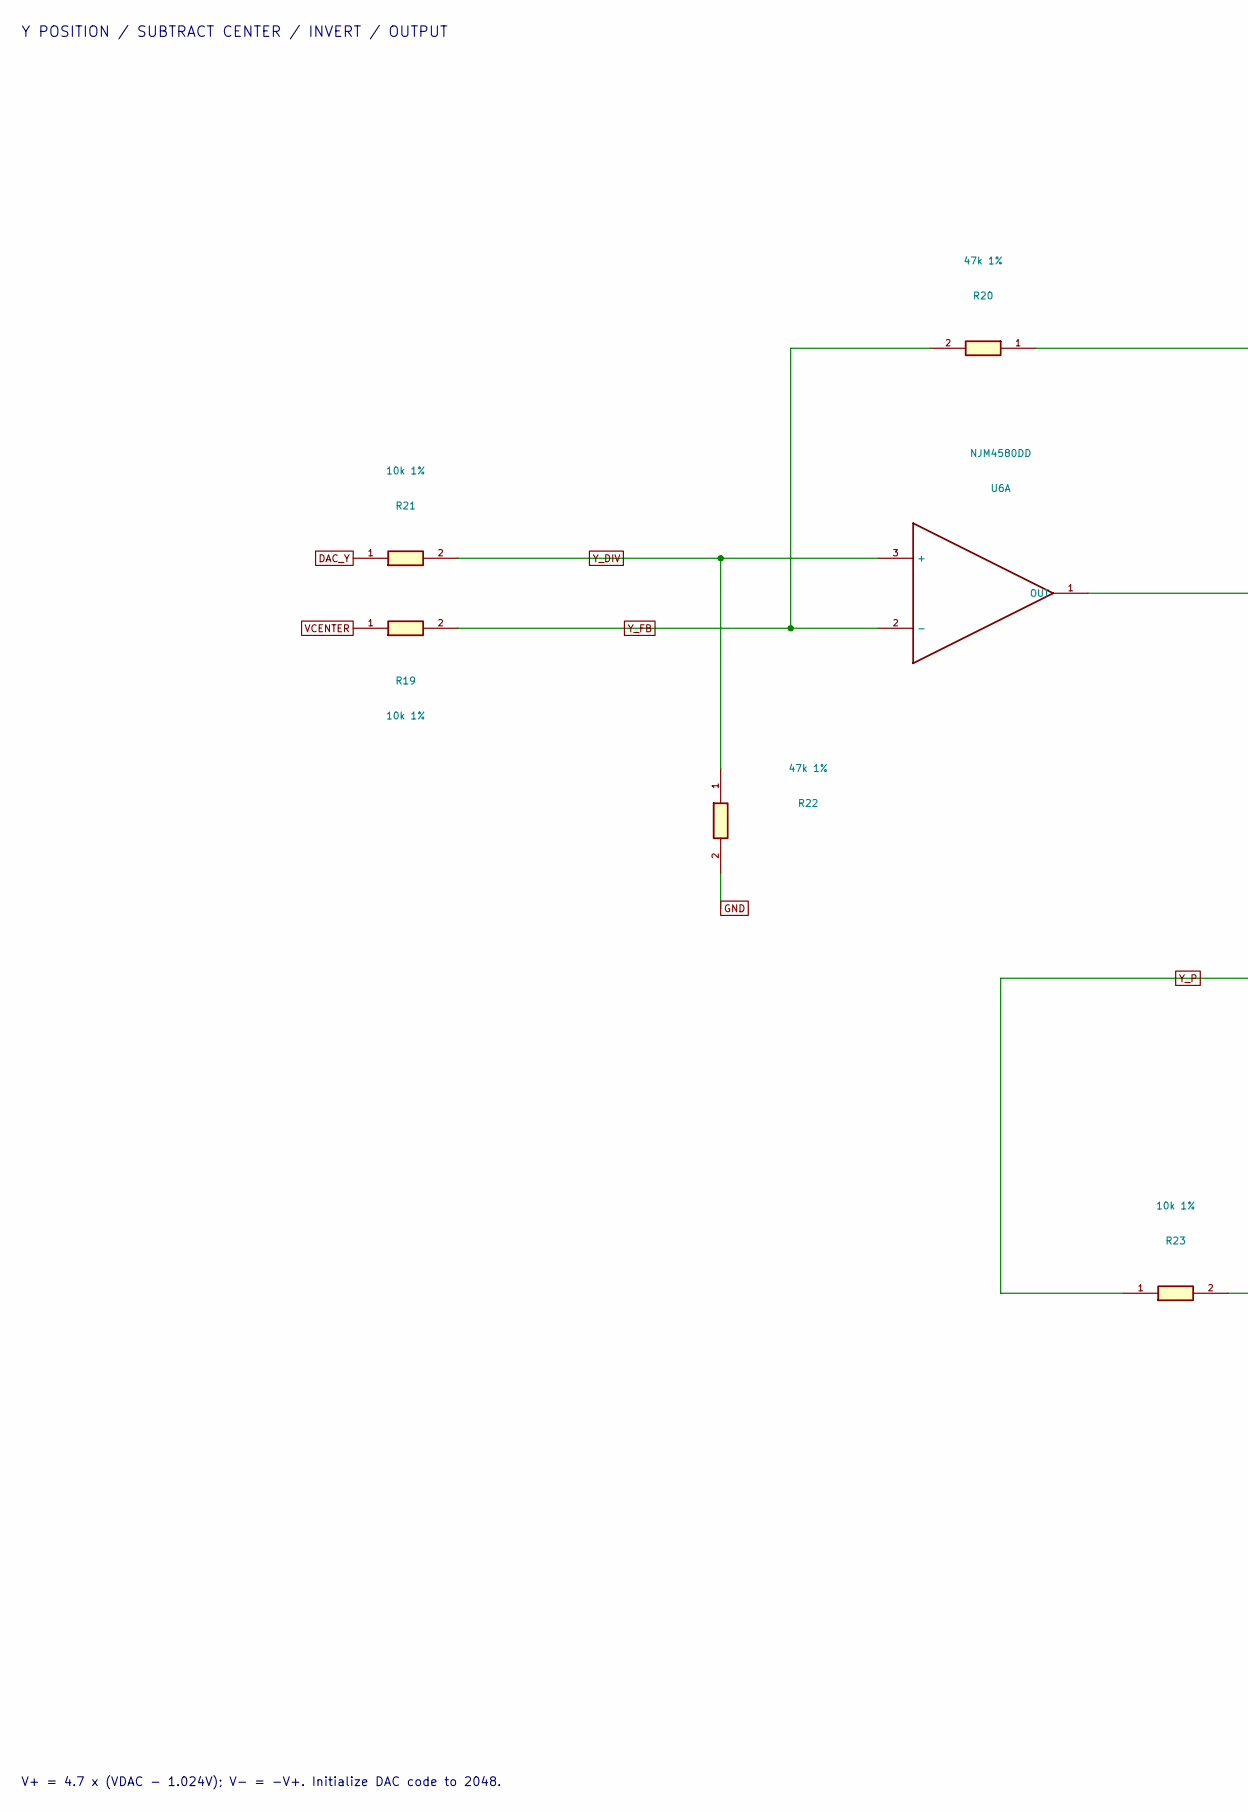
[picture p19: schematic 03_XY_differential_2.kicad_sch, Y / Differential position driver, part in row 1, column 1]

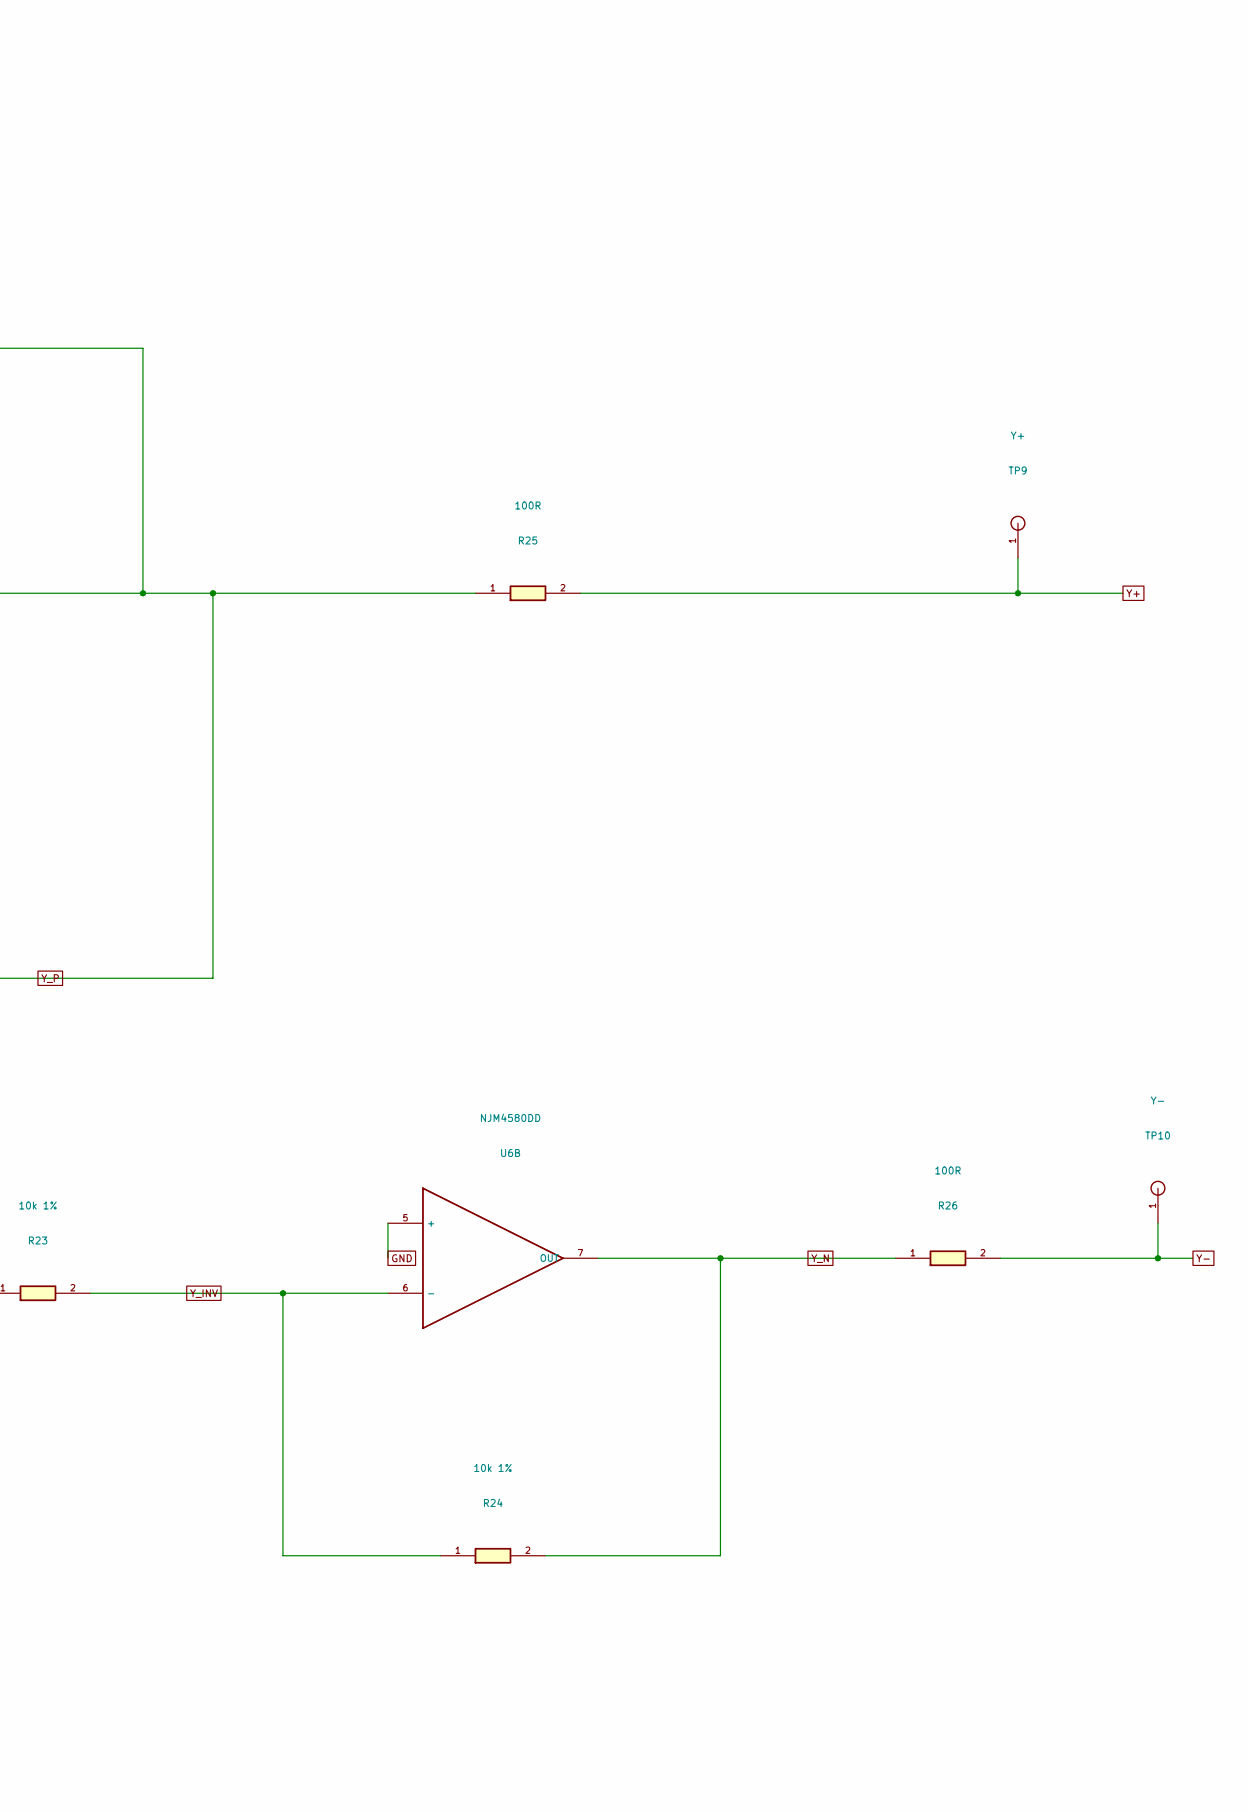
[picture p20: schematic 03_XY_differential_2.kicad_sch, Y / Differential position driver, part in row 1, column 2]

Parts:
R19, R21, R23, R24: 10k 1%; R_Axial_DIN0207_L6.3mm_D2.5mm_P10.16mm_Horizontal
R20, R22: 47k 1%; R_Axial_DIN0207_L6.3mm_D2.5mm_P10.16mm_Horizontal
R25, R26: 100R; R_Axial_DIN0207_L6.3mm_D2.5mm_P10.16mm_Horizontal
TP9: Y+; TestPoint_THTPad_D2.0mm_Drill1.0mm
TP10: Y-; TestPoint_THTPad_D2.0mm_Drill1.0mm
U6: NJM4580DD; DIP-8_W7.62mm

Connections:
DAC_Y: R21.1; also elsewhere on the board
GND: R22.2, U6.5 (+); also elsewhere on the board
VCENTER: R19.1; also elsewhere on the board
Y+: R25.2, TP9.1; also elsewhere on the board
Y-: R26.2, TP10.1; also elsewhere on the board
Y_DIV: R21.2, R22.1, U6.3 (+)
Y_FB: R19.2, R20.2, U6.2 (-)
Y_INV: R23.2, R24.1, U6.6 (-)
Y_N: R24.2, R26.1, U6.7 (OUT)
Y_P: R20.1, R23.1, R25.1, U6.1 (OUT)

Notes on the sheet:
Y POSITION / SUBTRACT CENTER / INVERT / OUTPUT
V+ = 4.7 x (VDAC - 1.024V); V- = -V+. Initialize DAC code to 2048.
