TakuroFukamizu/cores3-ilda/hardware/rev-a/kicad/CoreS3_ILDA_RevA.kicad_pcb

## KiCad design hardware/rev-a/kicad/CoreS3_ILDA_RevA.kicad_pcb (continued)

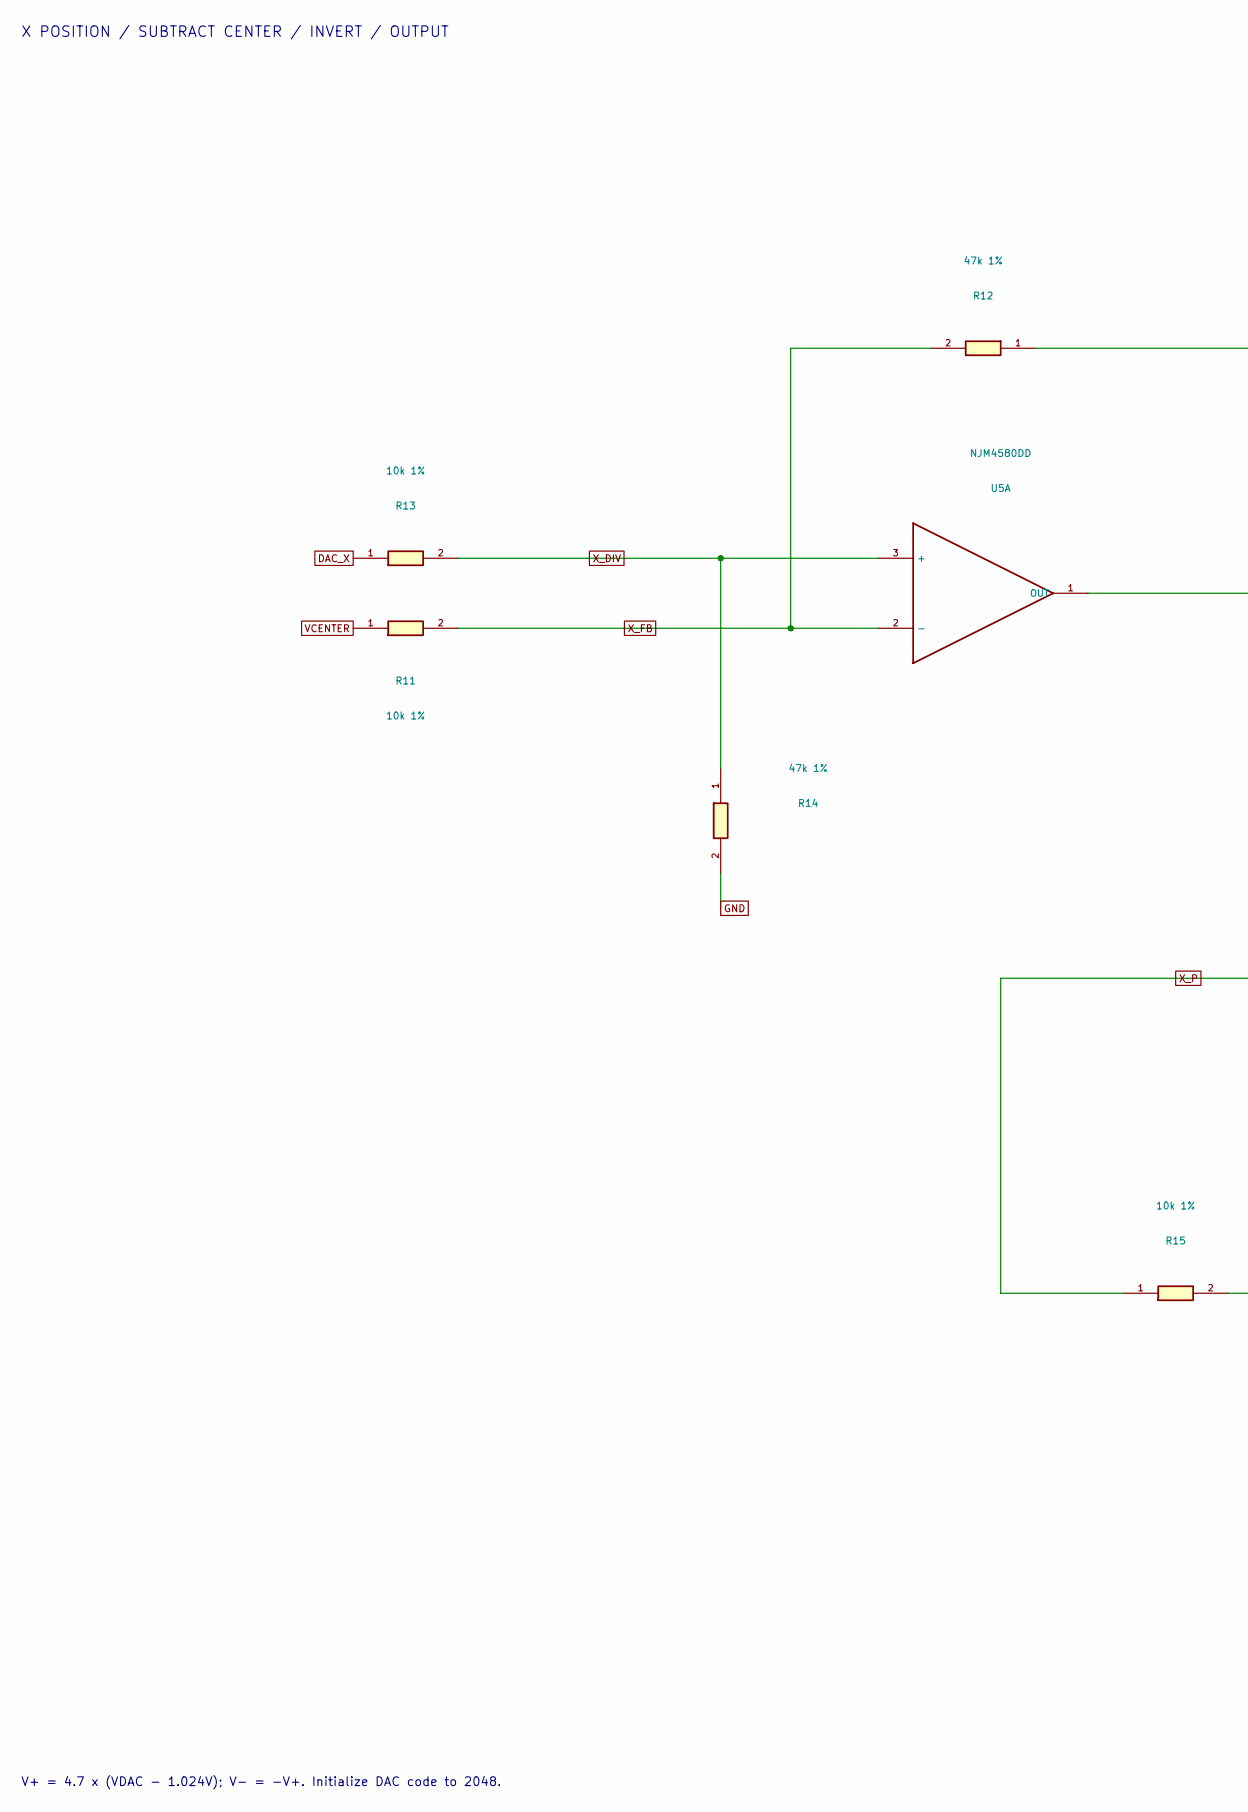
[picture p21: schematic 03_XY_differential_1.kicad_sch, X / Differential position driver, part in row 1, column 1]

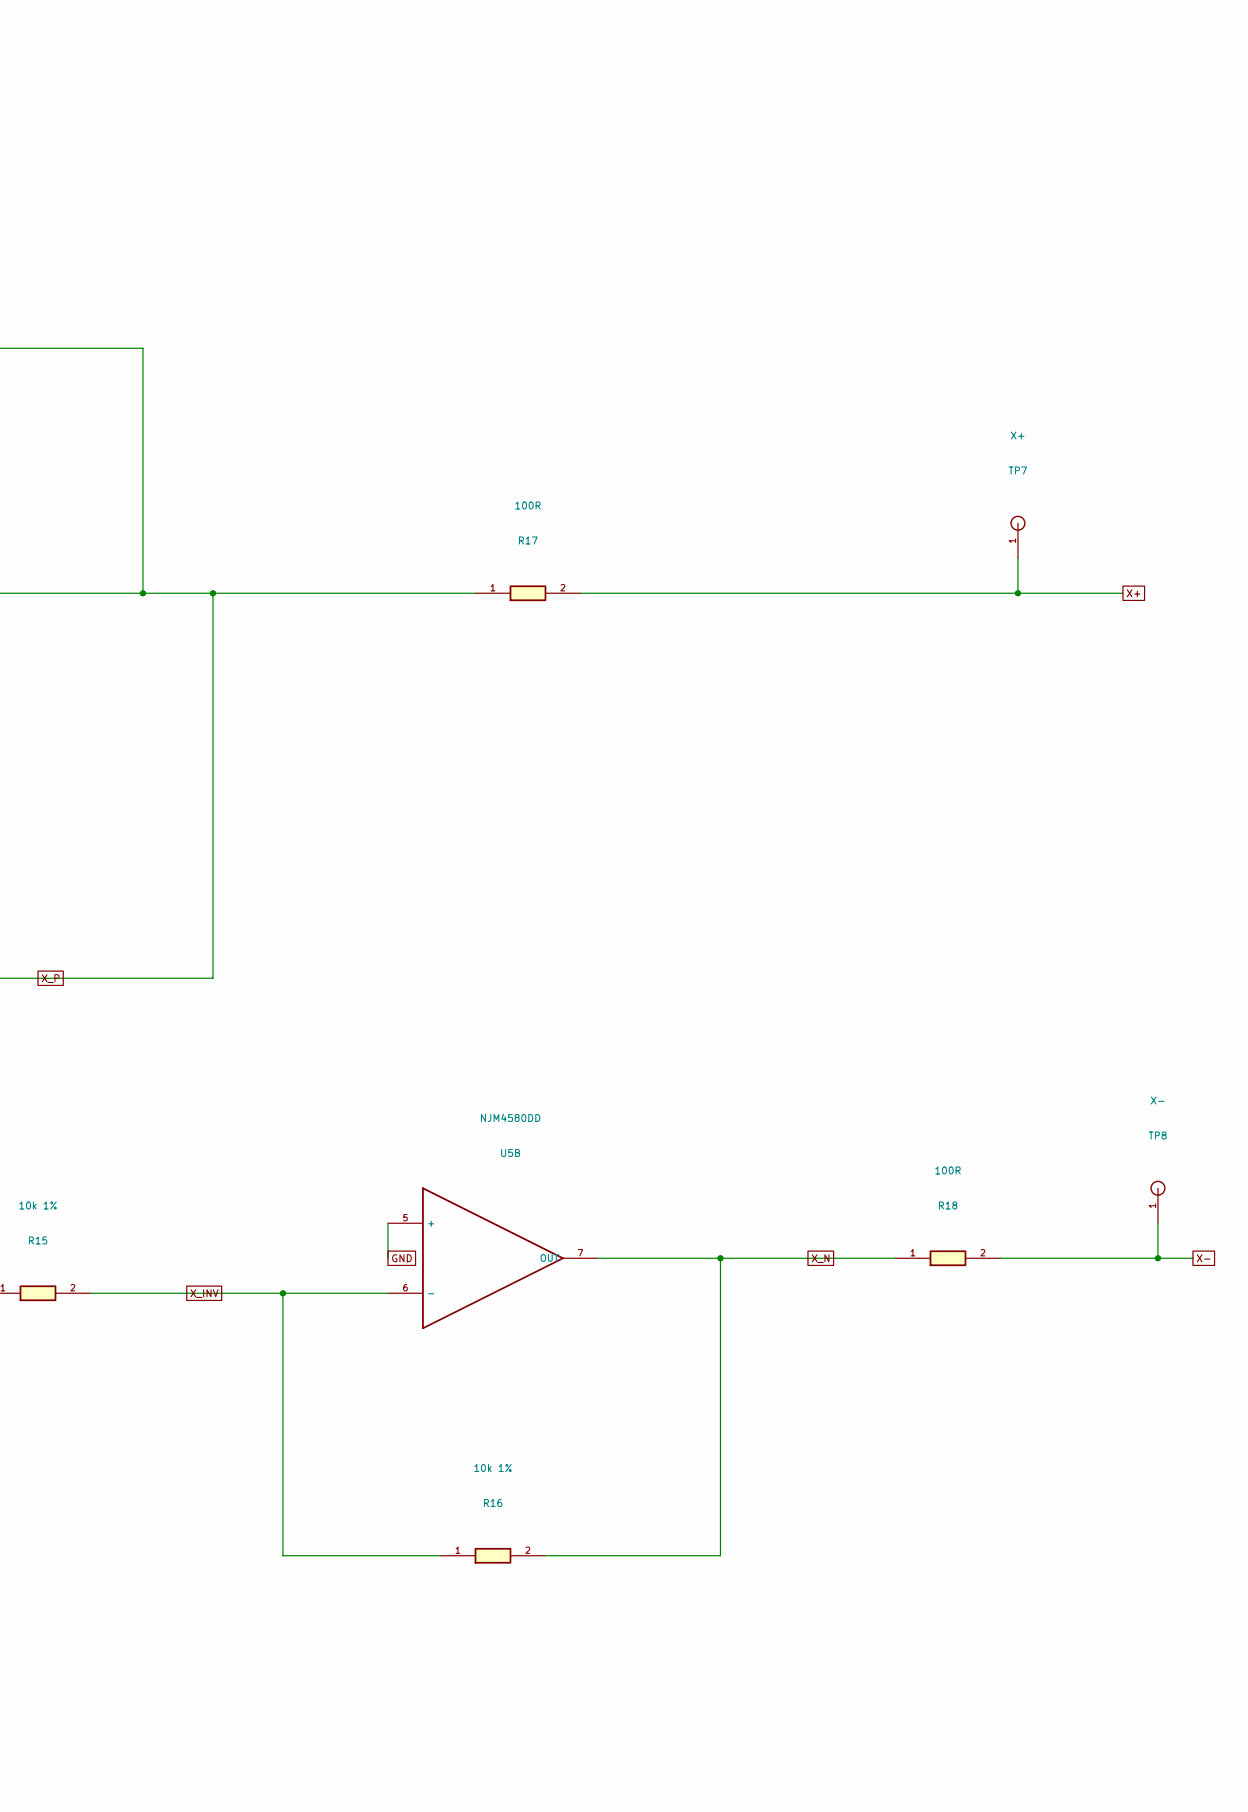
[picture p22: schematic 03_XY_differential_1.kicad_sch, X / Differential position driver, part in row 1, column 2]

Parts:
R11, R13, R15, R16: 10k 1%; R_Axial_DIN0207_L6.3mm_D2.5mm_P10.16mm_Horizontal
R12, R14: 47k 1%; R_Axial_DIN0207_L6.3mm_D2.5mm_P10.16mm_Horizontal
R17, R18: 100R; R_Axial_DIN0207_L6.3mm_D2.5mm_P10.16mm_Horizontal
TP7: X+; TestPoint_THTPad_D2.0mm_Drill1.0mm
TP8: X-; TestPoint_THTPad_D2.0mm_Drill1.0mm
U5: NJM4580DD; DIP-8_W7.62mm

Connections:
DAC_X: R13.1; also elsewhere on the board
GND: R14.2, U5.5 (+); also elsewhere on the board
VCENTER: R11.1; also elsewhere on the board
X+: R17.2, TP7.1; also elsewhere on the board
X-: R18.2, TP8.1; also elsewhere on the board
X_DIV: R13.2, R14.1, U5.3 (+)
X_FB: R11.2, R12.2, U5.2 (-)
X_INV: R15.2, R16.1, U5.6 (-)
X_N: R16.2, R18.1, U5.7 (OUT)
X_P: R12.1, R15.1, R17.1, U5.1 (OUT)

Notes on the sheet:
X POSITION / SUBTRACT CENTER / INVERT / OUTPUT
V+ = 4.7 x (VDAC - 1.024V); V- = -V+. Initialize DAC code to 2048.

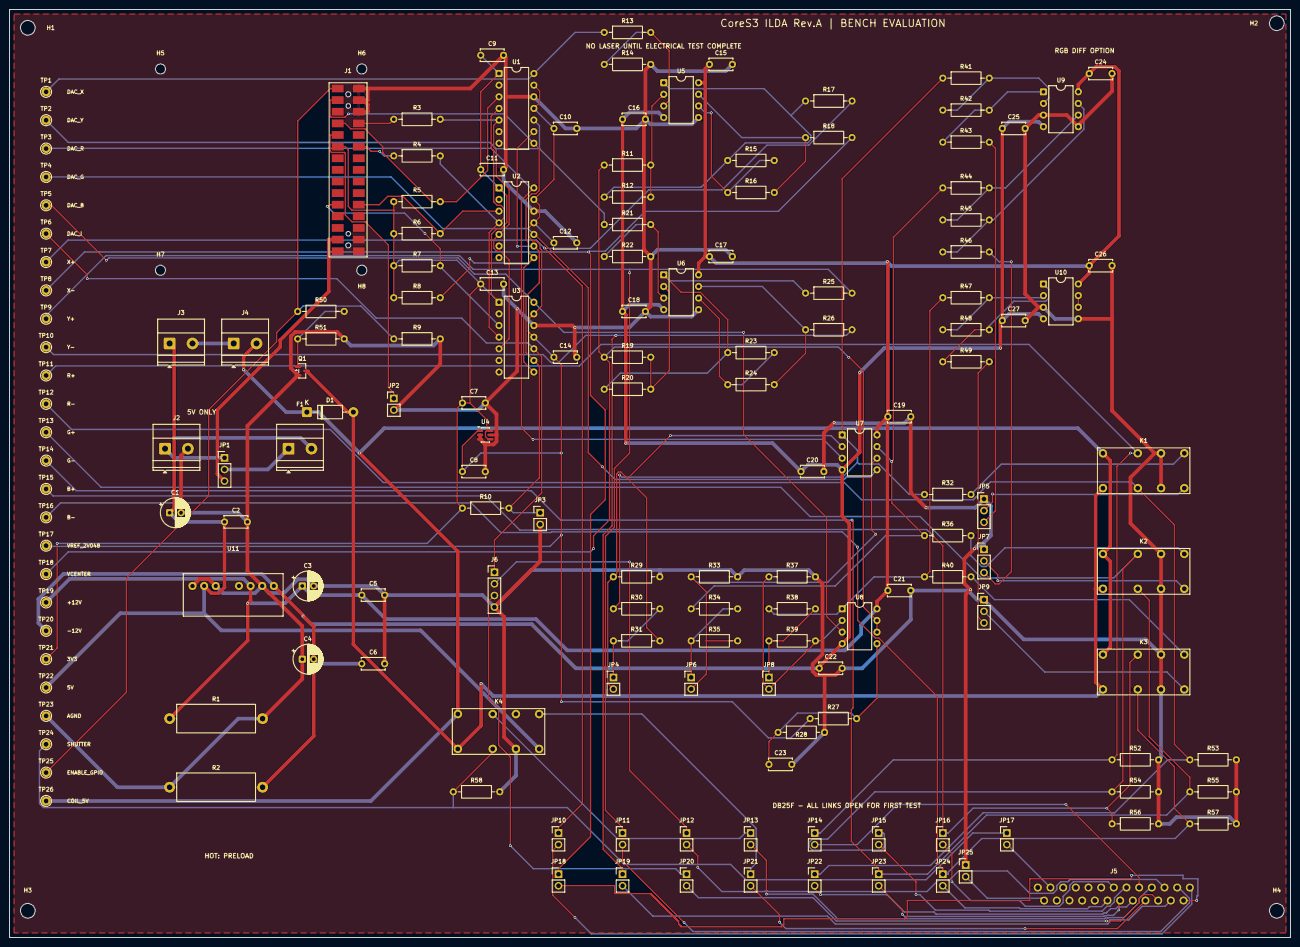
[picture p23: board CoreS3_ILDA_RevA.kicad_pcb from above]

Board: 2 copper layers, 280.0 x 202.8 mm, 168 parts (0 on the bottom side), 98 nets.

Other parts of the board:
H1, H2, H3, H4: MountingHole_3.2mm_M3
H5, H6, H7, H8: MountingHole_2.2mm_M2
