TakuroFukamizu/cores3-ilda/(commit log)

2026-10-05 Initial commit: CoreS3 ILDA Rev.A hardware and monorepo structure
    [01_Host_and_power_1.kicad_sch, 01_Host_and_power_2.kicad_sch, 02_DAC_and_reference_1.kicad_sch, 02_DAC_and_reference_2.kicad_sch, 03_XY_differential_1.kicad_sch, 03_XY_differential_2.kicad_sch, 04_RGB_and_center_1.kicad_sch, 04_RGB_and_center_2.kicad_sch]
2026-10-06 Redraw Rev.A schematics with functional blocks and explicit wiring
    [01_Host_and_power_1.kicad_sch, 01_Host_and_power_2.kicad_sch, 02_DAC_and_reference_1.kicad_sch, 02_DAC_and_reference_2.kicad_sch, 03_XY_differential_1.kicad_sch, 03_XY_differential_2.kicad_sch, 04_RGB_and_center_1.kicad_sch, 04_RGB_and_center_2.kicad_sch]
